tomer-gilan/Technion_Voice_Assistant_Summer_2026_A2/Documentation/edge-cases.md

<div dir="rtl">

# מקרי קצה (Edge Cases) - עוזר קולי על ESP32

קבוצה A2, קורס IoT, קיץ 2026.

מקרים שהמערכת יודעת לטפל בהם, ואיך רואים אותם בהדגמה.

</div>

<table dir="rtl">
<thead>
<tr><th align="center">#</th><th>המקרה</th><th>מה המערכת עושה</th><th>איך מדגימים</th></tr>
</thead>
<tbody>
<tr><td align="center">1</td><td>רעש בחדר במצב Hands-free (דפיקה על השולחן, מחיאת כף, צעדים)</td><td>גלאי הדיבור מזהה שזה לא דיבור, ולא מתחיל להקליט.</td><td>דופקים על השולחן ומוחאים כף ליד המכשיר. המצב נשאר Waiting for speech.</td></tr>
<tr><td align="center">2</td><td>שקט</td><td>במצב Hands-free שקט לא נשלח לענן בכלל. כשמשתמשים בכפתור, המערכת עונה במשפט כללי.</td><td>מפעילים Hands-free ושותקים: לא מתחילה הקלטה. לוחצים Talk ושותקים: העוזר עונה במשפט כללי.</td></tr>
<tr><td align="center">3</td><td>לחיצה על Talk כשהעוזר עדיין עונה</td><td>אי אפשר להתחיל הקלטה שנייה בזמן שהעוזר מדבר (גם בזמן ברכה, הודעת טיימר או תשובה לשאלה מוקלדת): הבקשה נדחית (גם <code>LISTEN</code> מהטרמינל וגם כפתור ה-BOOT, עם הודעה). מחכים שיסיים, או לוחצים Cancel.</td><td>באמצע תשובה כפתור ה-Talk מציג Busy ואי אפשר ללחוץ עליו, וגם מקש הרווח לא מתחיל הקלטה.</td></tr>
<tr><td align="center">4</td><td>הפסקה קצרה באמצע משפט</td><td>ההקלטה ממשיכה עד שנייה של שקט בערך (אפשר לשנות ב-Stop after silence).</td><td>אומרים משפט עם עצירה קצרה באמצע. הוא נשלח כשאלה אחת.</td></tr>
<tr><td align="center">5</td><td>החיבור ל-OpenAI נופל</td><td>הלוח מתחבר מחדש לבד, עם המתנה שגדלה בין ניסיון לניסיון (backoff: בערך 1, 2, 4 ו-8 שניות). אחרי 5 ניתוקים ברצף, או אחרי 30 שניות בלי חיבור, הוא עובר ל-Offline (נורית OpenAI אדומה) וממשיך לנסות כל 30 שניות, בלי להפסיק. כשהחיבור חוזר הוא מתאושש לבד.</td><td>מכבים בטלפון את הנתונים הסלולריים. אחרי כחצי דקה נורית ה-OpenAI נהיית כתומה, ואחרי עוד 30 שניות אדומה. מדליקים אותם שוב, ותוך 30 שניות לכל היותר הנורית חוזרת לירוק לבד.</td></tr>
<tr><td align="center">6</td><td>החיבור ל-Wi-Fi נופל</td><td>הלוח מזהה את הניתוק תוך כמה שניות ועובר ל-Offline (נוריות ה-Wi-Fi וה-OpenAI אדומות). הוא מנסה להתחבר שוב בעצמו כל 5 עד 15 שניות, בלי הגבלה. אם נשמרה רשת ממרכז הבקרה, אחרי 2 דקות בלי חיבור הוא עובר לרשת מ-<code>SECRETS.h</code>, ובחזרה באותו אופן. כשה-Wi-Fi חוזר הוא מתחבר מיד גם ל-OpenAI.</td><td>מכבים את ה-hotspot לכמה שניות ומדליקים אותו שוב. תוך כמה שניות נוריות ה-Wi-Fi וה-OpenAI נהיות אדומות (ב-OpenAI כתוב <code>waiting for Wi-Fi</code>), ואחרי שה-hotspot חוזר הן חוזרות לירוק לבד תוך כ- 5 עד 15 שניות.</td></tr>
<tr><td align="center">7</td><td>איפוס הלוח (Reset)</td><td>ההגדרות (עוצמת שמע, השתקה, בהירות, ספי האור, Hands-free) נשמרות ב-flash וחוזרות אחרי ההדלקה.</td><td>משנים את עוצמת השמע, לוחצים Reset, ובודקים שהעוצמה נשארה.</td></tr>
<tr><td align="center">8</td><td>מרכז הבקרה מתנתק באמצע</td><td>מופיע באנר אדום, וכשמתחברים שוב הדף מתחבר מחדש לבד ומקבל את המצב הנוכחי (STATUS).</td><td>לוחצים Disconnect ואז Connect, או מנתקים את כבל ה-USB ומחברים אותו שוב. כל הנוריות והמצב מופיעים שוב.</td></tr>
<tr><td align="center">9</td><td>עוצמת שמע מחוץ לטווח</td><td>הלוח מגביל את עוצמת השמע לטווח 0 עד 100.</td><td>אומרים <code>Set the volume to 150 percent</code>. העוצמה נעצרת ב-100%.</td></tr>
<tr><td align="center">10</td><td>דיבור ממרחק רגיל (מטר) עם רעש רקע</td><td>גלאי הדיבור מזהה את הדיבור גם כשיש רעש ברקע, והעוזר מבין את הבקשה ומבצע אותה.</td><td>אדם אחד מתופף על השולחן, והשני עומד במרחק מטר מהמכשיר ואומר <code>Turn on the light</code>. ה-LED נדלק.</td></tr>
<tr><td align="center">11</td><td>הטיימר נגמר כשאין חיבור ל-OpenAI</td><td>הטיימר רץ על הלוח עצמו, ולכן הוא מצפצף ומהבהב גם בלי אינטרנט. רק ההודעה הקולית צריכה חיבור: אם אין חיבור כשהטיימר נגמר, היא לא נאמרת.</td><td>מפעילים <code>Set a timer for 30 seconds</code> ומכבים את ה-hotspot. אחרי 30 שניות הלוח מצפצף.</td></tr>
<tr><td align="center">12</td><td>כמה בקשות חומרה בפקודה אחת</td><td>העוזר מזהה את כל הבקשות שבפקודה ומבצע את כולן יחד.</td><td>אומרים <code>Set the light brightness and the volume to 100 percent</code>. גם בהירות ה-LED וגם עוצמת השמע עולות ל-100%.</td></tr>
</tbody>
</table>
