tomer-gilan/Technion_Voice_Assistant_Summer_2026_A2/Documentation/user-stories.md

<div dir="rtl">

# USER STORIES - VOICE ASSISTANT

כל סיפור אומר **מה** המשתמש רוצה, והעמודה "הפתרון שלנו" אומרת **איך** בחרנו לממש את זה.

## הפעלה ושיחה בקול

<table dir="rtl">
<thead>
<tr><th align="center">#</th><th>סיפור המשתמש</th><th>הפתרון שלנו</th><th>מה עושים</th><th>מה אמור לקרות</th></tr>
</thead>
<tbody>
<tr><td align="center">1</td><td>בתור משתמש, אני רוצה <strong>לקבל תמונת מצב של תקינות הרכיבים במכשיר</strong>, כדי לדעת שהוא מוכן לשימוש.</td><td>לוח תקינות במרכז הבקרה עם נורית חיווי לכל רכיב, ותשובה קולית על מצב המכשיר בעקבות פקודה קולית מתאימה.</td><td>מחברים לחשמל ולוחצים Connect board. אחר כך אומרים <code>How are you doing</code>.</td><td>הנוריות נהיות ירוקות (Wi-Fi, SD card, Microphone, Speaker, OpenAI) והעוזר אומר ברכת פתיחה. עד שהשעון מסונכרן, נורית OpenAI מראה <code>Syncing the clock…</code>. לשאלה העוזר עונה כמה חזק אות ה-Wi-Fi, כמה זמן הלוח דלוק וכמה זיכרון פנוי.</td></tr>
<tr><td align="center">2</td><td>בתור משתמש, אני רוצה <strong>אפשרות להתחיל הקלטה בצורה נוחה ופשוטה מתוך הממשק</strong>, ולקבל תשובה בקול.</td><td>כפתור Talk במרכז הבקרה (או מקש רווח), ותשובה קולית מהרמקול שעל הלוח.</td><td>לוחצים Talk ושואלים <code>What is the capital of France</code>. רעיונות לשאלות בכרטיס Try saying.</td><td>הרמקול עונה תוך כשנייה.</td></tr>
<tr><td align="center">3</td><td>בתור משתמש, אני רוצה <strong>לעקוב בנוחות אחרי היסטוריית השיחה הנוכחית</strong>, כדי שיהיה לי תיעוד של השאלה ושל התשובה.</td><td>צ'אט במרכז הבקרה שמציג את השאלות והתשובות כבועות, עם מחוון מצב ותגית לכל פעולה שהמכשיר ביצע.</td><td>מסתכלים במרכז הבקרה בזמן השאלה.</td><td>המצב משתנה (Listening, Processing, Speaking), והשיחה מופיעה כבועות עם שעה וזמן תגובה. כשהעוזר מפעיל משהו בלוח (LED, חלק היום, עוצמה, טיימר, שעה, מצב הלוח) מופיעה בבועה תגית שאומרת מה הופעל.</td></tr>
</tbody>
</table>

## שליטה במכשיר בקול

<table dir="rtl">
<thead>
<tr><th align="center">#</th><th>סיפור המשתמש</th><th>הפתרון שלנו</th><th>מה עושים</th><th>מה אמור לקרות</th></tr>
</thead>
<tbody>
<tr><td align="center">4</td><td>בתור משתמש, אני רוצה <strong>לשלוט בתאורה בדיבור בלבד</strong>, בלי לגעת בכלום.</td><td>פקודה קולית שמדליקה, מכבה ומעמעמת את ה-LED שעל הלוח, עם אישור בקול.</td><td>אומרים <code>Turn on the light</code>, אחר כך <code>Dim the light to 30 percent</code>, ובסוף <code>Turn off the light</code>.</td><td>ה-LED נדלק והעוזר מאשר בקול. בעמעום סליידר הבהירות זז, ובסוף ה-LED נכבה.</td></tr>
<tr><td align="center">5</td><td>בתור משתמש, אני רוצה <strong>לשנות את עוצמת הקול של המכשיר בלי לגשת למחשב</strong>.</td><td>פקודה קולית לעוצמה, באחוזים או ביחס לעוצמה הנוכחית, עם אישור בקול. סליידר העוצמה במרכז הבקרה מתעדכן לבד.</td><td>אומרים <code>Set the volume to 30 percent</code>, אחר כך <code>A bit louder</code>.</td><td>סליידר העוצמה זז ל-30% והעוזר מאשר. בבקשה השנייה העוצמה עולה.</td></tr>
<tr><td align="center">6</td><td>בתור משתמש, אני רוצה <strong>תזכורות וטיימרים, ולדעת מה השעה</strong>, כדי לא לשכוח משהו בזמן שאני עסוק.</td><td>טיימר ותזכורת בפקודה קולית, עם ספירה לאחור במרכז הבקרה. בסוף: צפצוף, LED מהבהב והודעה קולית. אפשר לתזמן גם פעולה (כיבוי האור). את השעה העוזר אומר לפי שעון שמסונכרן מהרשת.</td><td>אומרים <code>Remind me in 30 seconds to check the oven</code>. אחר כך <code>Turn off the light in 20 seconds</code>, ובסוף <code>What time is it</code>.</td><td>במסך רואים ספירה לאחור. בסוף התזכורת הלוח מצפצף 3 פעמים, ה-LED מהבהב והעוזר אומר <code>Time's up - check the oven</code>. האור נכבה בסוף הטיימר השני. העוזר אומר את השעה.</td></tr>
<tr><td align="center">7</td><td>בתור משתמש, אני רוצה <strong>שהמכשיר ידע אם עכשיו יום, ערב או לילה לפי האור בחדר</strong>.</td><td>חיישן אור שהערך שלו מתורגם לחלק היום לפי ספים, ותשובה בקול. החיישן מדומה בסליידר במרכז הבקרה (לפי הנחיית מרצה הקורס).</td><td>מזיזים את סליידר Light sensor לערך נמוך ושואלים <code>Is it day or night</code>. מעלים את הערך ושואלים שוב. אפשר גם Simulate: Auto day-cycle (יום מדומה בכ-2 דקות, עם רעש כמו של חיישן אמיתי). נגיעה בסליידר מחזירה ל-Manual.</td><td>בערך נמוך העוזר עונה <code>night</code>, ובערך גבוה <code>day</code>. ב-Auto day-cycle הערך עובר לבד לילה, זריחה, יום ושקיעה.</td></tr>
</tbody>
</table>

## תקשורת נוחה וגמישה

<table dir="rtl">
<thead>
<tr><th align="center">#</th><th>סיפור המשתמש</th><th>הפתרון שלנו</th><th>מה עושים</th><th>מה אמור לקרות</th></tr>
</thead>
<tbody>
<tr><td align="center">8</td><td>בתור משתמש, אני רוצה <strong>יכולת לדבר עם המכשיר בקלות, בלי לחיצות כפתור</strong>, גם כשהידיים שלי תפוסות.</td><td>מצב Hands-free: זיהוי דיבור על הלוח שמתחיל להקליט לבד כשמדברים, עוצר כשמפסיקים ומתעלם מרעשים קצרים. מפעילים אותו במתג במרכז הבקרה או בפקודה קולית.</td><td>מדליקים את מתג Hands-free ואומרים משפט. אפשר גם בקול: עם Talk אומרים <code>Switch to hands-free mode</code>, ובחזרה <code>Go back to the button</code>.</td><td>הלוח מתחיל להקליט לבד, עוצר כשמפסיקים לדבר, ועונה. בבקשה בקול המתג זז לבד, אבל שאלה על המצב (<code>What is hands-free?</code>) לא מזיזה אותו.</td></tr>
<tr><td align="center">9</td><td>בתור משתמש, אני רוצה <strong>לנהל שיחה טבעית, שבה המכשיר זוכר מה אמרתי קודם</strong>.</td><td>שיחה רציפה מול OpenAI ששומרת את ההקשר של השאלות הקודמות.</td><td>אומרים <code>My name is Omri</code>, ואחר כך שואלים <code>What is my name</code>.</td><td>העוזר עונה <code>Omri</code>.</td></tr>
<tr><td align="center">10</td><td>בתור משתמש, אני רוצה <strong>אפשרות לתקשר עם המכשיר גם בחדר רועש במיוחד</strong>.</td><td>שדה לשאלה בכתב במרכז הבקרה. העוזר עונה עליה בקול, כמו על שאלה מדוברת.</td><td>כותבים בשדה Or type a question… (עד 200 בתים) ולוחצים Ask.</td><td>השאלה מופיעה בשיחה כבועה, והעוזר עונה בקול כרגיל.</td></tr>
<tr><td align="center">11</td><td>בתור משתמש, אני רוצה <strong>לבטל שאלה באמצע</strong>, בלי לחכות לתשובה שכבר לא צריך.</td><td>כפתור Cancel במרכז הבקרה שמוחק את ההקלטה ומחזיר את המכשיר למצב מוכן.</td><td>לוחצים Talk ומיד Cancel.</td><td>ההקלטה נמחקת, העוזר לא עונה והלוח חוזר ל-Ready (בטרמינל: <code>LISTEN #N CANCELLED</code>). כל עוד העוזר מדבר (גם בברכה, בהודעת טיימר או בתשובה לשאלה בכתב), Talk נדחה: מחכים שיסיים, או לוחצים Cancel.</td></tr>
</tbody>
</table>

## תיעוד

<table dir="rtl">
<thead>
<tr><th align="center">#</th><th>סיפור המשתמש</th><th>הפתרון שלנו</th><th>מה עושים</th><th>מה אמור לקרות</th></tr>
</thead>
<tbody>
<tr><td align="center">12</td><td>בתור משתמש, אני רוצה <strong>לשמוע שוב פקודה שאמרתי ותשובה שקיבלתי</strong>, כדי לבדוק מה נקלט.</td><td>ההקלטות נשמרות בכרטיס SD שעל הלוח, ומנגנים אותן במחשב מלשונית ההקלטות במרכז הבקרה.</td><td>בלשונית ההקלטות בוחרים פקודה אחרונה ומנגנים אותה.</td><td>ההקלטה מתנגנת מהמחשב, עם waveform. אפשר גם למחוק אותה. גם עם Hands-free דלוק הלוח לא מתייחס לניגון כשאלה: המיקרופון לא מקשיב עד שהניגון נגמר או נעצר.</td></tr>
</tbody>
</table>

## התאמה אישית

<table dir="rtl">
<thead>
<tr><th align="center">#</th><th>סיפור המשתמש</th><th>הפתרון שלנו</th><th>מה עושים</th><th>מה אמור לקרות</th></tr>
</thead>
<tbody>
<tr><td align="center">13</td><td>בתור משתמש, אני רוצה <strong>להתאים את הקול והתאורה של המכשיר לחדר</strong>.</td><td>סליידרים ומתגים במרכז הבקרה: עוצמה (עם Test beep), השתקה ובהירות LED.</td><td>מזיזים את סליידר העוצמה ולוחצים Test beep, מסמנים Mute, משנים את בהירות ה-LED.</td><td>הצפצוף נשמע בעוצמה החדשה, Mute משתיק את הרמקול, וה-LED משנה בהירות.</td></tr>
<tr><td align="center">14</td><td>בתור משתמש, אני רוצה <strong>שהמכשיר יגיב לדיבור שלי אבל לא יופעל סתם מרעש</strong>, ולא יקטע אותי באמצע משפט.</td><td>כיוון של Hands-free במרכז הבקרה: רגישות (Sensitivity) ומשך השקט שמסיים הקלטה (Stop after silence).</td><td>משנים Sensitivity ו-Stop after silence ובודקים שוב דיבור ורעש.</td><td>דיבור עדיין מפעיל הקלטה, ורעש קצר (דפיקה) לא. ההקלטה נעצרת אחרי זמן השקט שנבחר.</td></tr>
</tbody>
</table>

## בלי מחשב

<table dir="rtl">
<thead>
<tr><th align="center">#</th><th>סיפור המשתמש</th><th>הפתרון שלנו</th><th>מה עושים</th><th>מה אמור לקרות</th></tr>
</thead>
<tbody>
<tr><td align="center">15</td><td>בתור משתמש, אני רוצה <strong>יכולת להפעיל את המכשיר גם בלי לפתוח את מרכז הבקרה</strong>.</td><td>הפעלת האזנה בלחיצה על כפתור BOOT שעל הלוח, כחלופה לכפתור Talk.</td><td>פעם אחת מדליקים BOOT button בכרטיס On the board itself (הבחירה נשמרת בלוח). מעכשיו לוחצים על BOOT שעל הלוח ושואלים <code>What time is it</code>, בלי לגעת במרכז הבקרה.</td><td>נשמע צליל קצר וגבוה, הלוח מקליט 3 שניות והעוזר עונה בקול. לחיצה כשהלוח לא יכול להקשיב (למשל באמצע תשובה, או בלי רשת) נותנת צליל נמוך וקצר.</td></tr>
</tbody>
</table>

## סטטיסטיקה

<table dir="rtl">
<thead>
<tr><th align="center">#</th><th>סיפור המשתמש</th><th>הפתרון שלנו</th><th>מה עושים</th><th>מה אמור לקרות</th></tr>
</thead>
<tbody>
<tr><td align="center">16</td><td>בתור משתמש, אני רוצה <strong>לקבל סטטיסטיקות על פעילות המכשיר במהלך הסשן</strong>, כדי לדעת כמה מהר הוא עונה ובמה השתמשתי.</td><td>חלונית Statistics במרכז הבקרה עם מדדים וגרף, ייצוא ל-CSV, ומסך סיכום שנשמר כדוח.</td><td>פותחים את חלונית Statistics, לוחצים Export CSV, ובסוף Summary ו-Save report.</td><td>בחלונית: מספר הפקודות, זמן תגובה ממוצע, הכי מהיר והכי איטי, הפעלות בקול (LED, עוצמה), שינויים בחיישן האור, וגרף של זמן התגובה לכל פקודה. ה-CSV כולל תאריך ושעה, מספר ההפעלה של הלוח ומספר הפקודה בה. Summary מראה הכל בגדול עם ההגדרות של הלוח, ו-Save report שומר דף HTML אחד.</td></tr>
</tbody>
</table>

</div>
