tomer-gilan/Technion_Voice_Assistant_Summer_2026_A2/docs/quick-start.pdf

# מדריך מהיר - עוזר קולי על 32ESP

קבוצה 2A, קורס IoT, קיץ .2026 דף אחד כדי להפעיל את המערכת לבד. כל הקוד והמסמכים נמצאים בריפו ב-GitHub( סורקים את ה-QR).

## להתחיל

.1 הלוח מחובר ב-USB למחשב, וה-hotspot של הטלפון דלוק. .2 ב-Chrome פתוח מרכז הבקרה ) html.app_audio_reply/tools) . לוחצים board Connect ובוחרים את ה-COM של הלוח. .3 מחכים שכל הנורות למעלה יהיו ירוקות. העוזר אומר משפט פתיחה. אפשר ללחוץ test-Self לבדיקה מהירה של כל החלקים. .4 לוחצים Talk( או רווח( ומדברים באנגלית, עד 3 שניות. או מדליקים free-Hands ופשוט מדברים. לא מכירים את המסך? כפתור Tour למעלה עושה סיור קצר.

## מה לנסות

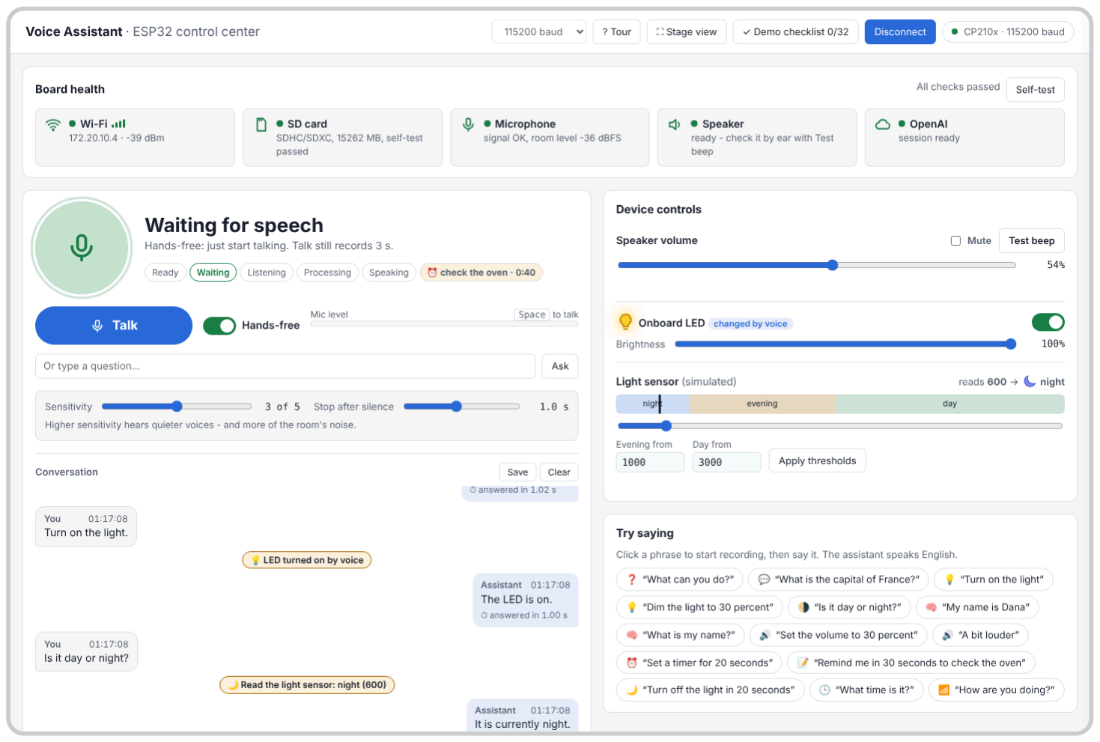
[picture p7: figure]

| | נושא מה להגיד מה יקרה
| | מה הוא יודע ?do you can What הוא מפרט במשפט אחד
| | שאלה כללית ?France of capital the is What עונה בקול תוך כשנייה
ה-LED נדלק ומתעמעם, והנורה במסך זוהרת בהתאם | ואז Turn on the light Dim the light to 30 percent | אור
הסליידר זז והוא מאשר | ואז Set the volume to 30 percent A bit louder | עוצמה
LED , צפצופים ובסוף , לאחור ספירה מהבהב Time's up - check the oven -ו | Remind me in 30 seconds to check the oven | תזכורת
| | שעה ?it is time What השעה והתאריך מהשעון של הלוח
| | חלק היום ?night or day it Is לפי סליידר האור )מדמה חיישן(
השם את זוכר | What is my name? ואז My name is Dana | זיכרון

## מה רואים במסך

העיגול הגדול: מה העוזר עושה עכשיו. ירוק מוכן, אדום מקשיב, כתום חושב, כחול מדבר. Conversation: מה הוא שמע ומה ענה, תוך כמה זמן, ומה הוא הפעיל בלוח. controls Device: עוצמה, השתקה, LED וחיישן האור. ההגדרות נשמרות בלוח גם אחרי Reset. Statistics: כמה פקודות, זמני תגובה וגרף. Summary מציג הכל במסך מלא. view Stage( מקש F): העוזר בגדול, למי שעומד רחוק.

## אם משהו לא עובד

| מה רואים מה עושים
| נורית אדומה ב-Fi-Wi או ב-OpenAI לבדוק את ה-hotspot וללחוץ (EN (Reset על הלוח
| באנר אדום על ה-USB לחבר את הכבל שוב. מרכז הבקרה מתחבר לבד
אפשר לכתוב את השאלה בשדה שמתחת ל-Talk | הוא לא הבין לדבר קרוב יותר, באנגלית, ולבדוק בבועה מה הוא שמע. בחדר רועש
| free-Hands נדלק מרעש להוריד את Sensitivity, או להשתמש ב-Talk
