tomer-gilan/Technion_Voice_Assistant_Summer_2026_A2/docs/questions.md

<div dir="rtl">

# שאלות שבוחנים עשויים לשאול - ותשובות קצרות

קבוצה A2, קורס IoT, קיץ 2026. דף הכנה לצוות לפני ההדגמה. כל המספרים מה-[README](../README.md) ומ-[איך הקוד בנוי](architecture.md).

## חומרה וזיכרון

**למה לא מקליטים את כל השאלה ואז שולחים?**

ל-ESP32 שלנו אין PSRAM. 3 שניות של אודיו ב-24kHz ו-16 ביט הן כ-144KB, וכשהחיבור ל-OpenAI פתוח נשארים פנויים רק כ-45KB. לכן כל חתיכה של 100ms נשלחת מיד.

**למה התשובה מגיעה ב-mu-law ב-8kHz?**

זה קטן פי 6 מ-PCM ב-24kHz (64 kbps במקום 384), אז התשובה נכנסת במאגר הניגון של 32KB. האיכות מספיקה לדיבור.

**מה תופס הכי הרבה זיכרון?**

החיבור המוצפן וה-WebSocket, כ-51KB. בזמן שיחה נשארים כ-45KB פנויים, יציב לאורך 26 שאלות, כלומר אין דליפה.

**איך המיקרופון והרמקול עובדים ביחד?**

שניהם על אותם שעוני I2S (BCLK ו-LRC מחוברים לשניהם), עם פורט I2S אחד במצב full-duplex. ראו את [דיאגרמת החיבורים](images/wiring.png).

## תוכנה

**מה קורה כשהרשת איטית?**

משימת FreeRTOS נפרדת קוראת את המיקרופון כל 20ms לתור של כ-1.36 שניות. שליחה איטית רק מעכבת את האודיו ולא מאבדת אותו. את זה מצאנו במדידות: לפני התיקון אבדו דגימות ב-21 מתוך 26 שאלות.

**איך המודל מדליק את ה-LED?**

בהודעת ההגדרות לסשן הגדרנו 6 "כלים" עם סכמת JSON. המודל מחליט לקרוא לכלי, ה-ESP32 מבצע ומחזיר תשובה, והמודל אומר בקול מה נעשה. הקוד לא מנסה להבין טקסט בעצמו.

**איך Hands-free יודע שזה דיבור ולא דפיקה?**

גלאי הקול בודק עוצמה בתחום התדרים של דיבור לעומת רעש החדר, אם הקול "קולי", ואם יש בו קצב של הברות. דפיקות, מחיאות כפיים וצעדים אף פעם לא התחילו הקלטה בבדיקה על 112 קטעי רעש.

**למה העוזר לא עונה לעצמו?**

בזמן תשובה ועוד 0.6 שניות אחריה המיקרופון לא מקשיב (half-duplex).

**מה נשמר אחרי Reset?**

עוצמה, השתקה, בהירות LED, ספי האור והגדרות Hands-free, ב-flash (NVS, דרך `Preferences`).

**איך מעבירים קבצים מה-SD למחשב בלי Wi-Fi נוסף?**

באותו כבל USB. הלוח שולח את הבייטים בין `@@GET_BEGIN` ל-`@@GET_END`, ומרכז הבקרה בודק CRC-32 כדי לדעת שהקובץ הגיע שלם.

## ביצועים

**כמה מהר הוא עונה?**

חציון של כ-1.1 שניות מסוף ההקלטה עד הצליל הראשון. 23 מתוך 26 שאלות התחילו לענות תוך פחות מ-2 שניות. האיטיות היו בדיבור שקט או מרחוק.

**כמה זמן לוקחת הדלקה?**

6.8 עד 10.8 שניות עד שמוכן לשיחה. החלק הארוך הוא החיבור המוצפן ל-OpenAI, 3.9 עד 5.1 שניות.

## מגבלות

**למה רק אנגלית?**

ניסינו עברית: התשובות חזרו באנגלית והתמלול השתבש.

**מה קורה בלי אינטרנט?**

העוזר לא עונה. טיימר שכבר רץ עדיין מצלצל, כי הוא רץ על הלוח עצמו.

**מה הייתם משפרים?**

הצעה (כדאי להחליט ביחד): חיבור LDR אמיתי (הקוד כבר מוכן), עברית, ותגובה מהירה יותר בדיבור שקט.

</div>
