tomer-gilan/Technion_Voice_Assistant_Summer_2026_A2/docs/versions.md

<div dir="rtl">

# גרסאות הפרויקט - איך בנינו את העוזר, שלב אחר שלב

קבוצה A2, קורס IoT, קיץ 2026. בנינו את הפרויקט בצעדים קטנים. כל שלב הוא sketch שלם שעובד לבד, ובראש כל קובץ כתוב מה הוא מוסיף ואיך בודקים שהוא עבר. השלבים הישנים נשמרו בתיקייה `test/` בשם `NN_*.ino.inactive`, כדי שה-Arduino IDE לא יקמפל אותם. הגרסה הנוכחית היא `test/test.ino` (שלב 30 והשיפורים שאחריו).

## 1. החומרה (שלבים 2-5)

| שלב | מה נבדק |
|---|---|
| 02 | צליל 440Hz ברמקול דרך המגבר MAX98357A. בודק את החיבורים של הרמקול |
| 03 | המיקרופון INMP441: מדפיס מינימום, מקסימום ו-RMS כל חצי שנייה |
| 04 | הקלטה ואז השמעה (loopback). שני הרכיבים חולקים את אותם שעוני I2S |
| 05 | חיבור ל-Wi-Fi, עם חיבור מחדש אוטומטי |

## 2. ניסיון ראשון עם Gemini Live (שלבים 6-8)

| שלב | מה נבדק |
|---|---|
| 06 | חיבור מוצפן (TLS + WebSocket) לשרת של Gemini |
| 07a / 07b | הודעת הגדרה מינימלית, ואחר כך מלאה עם הוראות וכלי ל-LED |
| 08a | שאלה בטקסט ותשובה. למדנו שמודלי האודיו של Gemini עונים רק באודיו, לא בטקסט |
| 08b | שליחת אודיו אמיתי מהמיקרופון בחתיכות של 100ms, בלי לשמור את כל ההקלטה ב-RAM |

## 3. מעבר ל-OpenAI Realtime (שלבים 9-16)

| שלב | מה נוסף |
|---|---|
| 09 | חיבור מוצפן ל-OpenAI עם אימות בכותרת `Authorization` |
| 10 | הודעת `session.update` (מודל, הוראות, פורמט אודיו) ואישור מהשרת |
| 11 | שאלה בטקסט ותשובה |
| 12 | אודיו מהמיקרופון לשרת, בחתיכות קטנות |
| 13 | השמעת התשובה ברמקול, חתיכה אחרי חתיכה |
| 14 | תמלול של שני הצדדים, ושיחה שזוכרת את השאלות הקודמות |
| 15 | הכלי הראשון: `set_board_state` מדליק ומכבה את ה-LED |
| 16 | הרבה שאלות ברצף וחיבור מחדש ברור כשהרשת נופלת |

## 4. סדר בקוד והתנהגות (שלבים 17-22)

| שלב | מה נוסף |
|---|---|
| 17 | פקודות לוג (`LOG_ERROR` / `LOG_INFO` / `LOG_DEBUG`) במקום הדפסות מפוזרות |
| 18 | תשובות קצרות: משפט אחד |
| 19 | לחיצה על כפתור BOOT מתחילה הקלטה, כמו הפקודה `LISTEN` |
| 20a | פירוק הקוד למודולים (`*_utils.cpp/.h`) |
| 21 | תיקון באג: שקט חוזר הדליק וכיבה את ה-LED בלי שביקשו |
| 22 | ברכת פתיחה אקראית כשהלוח מוכן |

## 5. יכולות (שלבים 23-29)

| שלב | מה נוסף |
|---|---|
| 23 | הכלי `get_time_of_day`: יום, ערב או לילה לפי חיישן אור (בהתחלה מדומה) |
| 24 | כרטיס SD לצד החיבור ל-OpenAI, ומדידת זיכרון בכל שלב בהדלקה |
| 25 | שמירת התשובות ב-SD, והעברת קבצים למחשב (`LIST` / `GET` / `DELETE`) |
| 27 | שמירת ההקלטה מהמיקרופון ב-SD, כדי לשמוע מה הלוח שמע |
| 28 | מרכז הבקרה בדפדפן: שורות `@@` עם מצב הלוח, וכפתורים ל-LED, עוצמה וצפצוף |
| 29 | מדידות זמן וזיכרון בכל שאלה, וסקריפט שמסכם אותן (ראו "מדידות ביצועים" ב-README) |

אין קובץ לשלב 26. הקוד של שלב 28 נמצא בתוך שלב 29, שבנוי ישירות עליו.

## 6. הגרסה הנוכחית (שלב 30, `test/test.ino`)

| מה | איפה |
|---|---|
| Hands-free: גלאי קול (VAD) שמתחיל ועוצר את ההקלטה לבד | `vad_utils`, `hands_free_utils` |
| משימה נפרדת שקוראת את המיקרופון כל 20ms, עם 500ms לפני תחילת הדיבור | `mic_capture_utils` |
| כלי לבדיקת הגלאי על קבצי WAV במחשב | `tools/vad_replay.cpp` |
| מרכז הבקרה: Hands-free, מד עוצמת קול, סליידרים, סטטיסטיקה | `tools/reply_audio_app.html` |

### השיפורים לקראת ההגשה

| תחום | מה נוסף |
|---|---|
| כלים קוליים | עוצמה באחוזים (`set_volume`), עמעום, שעה ותאריך, טיימר ותזכורת, `How are you doing?` (`get_board_status`), `What can you do?` |
| קושחה | הטיימר מצלצל גם בלי אינטרנט, שאלה בכתב לחדר רועש (`ASK`), תמיכה ב-LDR אמיתי |
| מרכז הבקרה | Tour לבוחנים, Self-test, Demo checklist שמסמן לבד, שעון הדגמה, Stage view, Summary, Save report, ניגון לוג שמור |
| מסמכים | README ויזואלי, סיפורי משתמש ומקרי קצה להדפסה, מדריך מהיר, תוכנית הדגמה, מבנה הקוד, דיאגרמת חיבורים, והמסמך הזה |

הרשימה המלאה, commit אחרי commit: [PROGRESS.md](../PROGRESS.md).

## גרסאות התוכנה

גרסאות ה-IDE, ה-ESP32 core, הספריות והמודל: בטבלה "תוכנה וגרסאות" ב-[README](../README.md).

</div>
