tomer-gilan/Technion_Voice_Assistant_Summer_2026_A2/docs/edge-cases.pdf

# מקרי קצה - עוזר קולי על 32ESP

### קבוצה 2A, קורס IoT, קיץ .2026

מקרים שהמערכת יודעת לטפל בהם, ואיך אפשר לראות את זה בהדגמה.

| | | # המקרה מה המערכת עושה איך מדגימים ✓
.speech | גלאי הקול מזהה שזה לא דיבור ולא מתחיל להקליט. דופקים על השולחן ומוחאים כפיים ליד המכשיר. המצב נשאר for Waiting | על השולחן, מחיאת כפיים, צעדים( | 1 רעש בחדר במצב free-Hands( דפיקה
משתעלים ליד המכשיר. ב-GUI מופיעה הודעה שהצליל נזרק, או בבועה כתוב .(no words - just a sound) | נשלחה ו-OpenAI לא שמע מילים, זה נספר כרעש והמודל לא מפעיל את ה-.LED | | 2 צליל שדומה לדיבור )שיעול, צחוק( אם ההקלטה התחילה והתברר שזה לא דיבור, היא נזרקת ולא נשלחת. אם
מוחאים כפיים או משתעלים כמה פעמים ברצף. ב-GUI מופיעה הודעה על הפסקה. | הזמן. | | 3 הרבה רעשים ברצף אחרי 3 רעשים ברצף ההאזנה עוצרת ל5- שניות, כדי לא לשלוח רעש לענן כל
free-Hands דלוק, שואלים שאלה עם תשובה ארוכה. אחרי התשובה הוא חוזר ל-Waiting ולא מתחיל שיחה לבד. | את עצמו. | | 4 העוזר שומע את עצמו מהרמקול בזמן תשובה ו0.6- שניות אחריה המיקרופון לא מקשיב, כך שהעוזר לא מפעיל
free-Hands דלוק ושותקים: לא מתחילה הקלטה. | הוראה להפעיל את ה-LED רק אם שמע בקשה ברורה. | | 5 שקט במצב free-Hands שקט לא נשלח לענן בכלל. במצב לחיצה, המודל מקבל
באמצע תשובה הכפתור Talk כתוב Busy ולא לוחץ, וגם רווח לא מתחיל הקלטה. | נדחה עם הודעה שהמיקרופון תפוס. | | 6 לוחצים Talk כשהעוזר עוד עונה אי אפשר להתחיל הקלטה שנייה באמצע תשובה. גם LISTEN מהטרמינל
| | | 7 משפט ארוך מאוד במצב free-Hands ההקלטה נעצרת אחרי 10 שניות לכל היותר, והעוזר עונה על מה שנשמע. מדברים ברצף יותר מ10- שניות. הכפתור מתמלא עד הסוף וההקלטה נעצרת.
| | | 8 הפסקה קצרה באמצע משפט ההקלטה ממשיכה עד שקט של כשנייה )אפשר לשנות ב-silence after Stop). אומרים משפט עם עצירה קצרה באמצע. הוא נשלח כשאלה אחת.
בשורת המדידה של השאלה רואים כמה זמן האודיו חיכה בתור )ms_max_fifo )ושלא אבד כלום. | התור מתמלא, יש הודעה כמה אודיו אבד. | | 9 Fi-Wi איטי בזמן הקלטה האודיו מחכה בתור עד 1.36 שניות ונשלח באיחור במקום ללכת לאיבוד. אם
מכבים את ה-hotspot לכמה שניות ומדליקים. נורית OpenAI חוזרת לירוק. | ניסיונות כושלים ברצף הוא עוצר עם נורית OpenAI אדומה והסבר, במקום לנסות לנצח. | | 10 החיבור ל-OpenAI נופל הלוח מתחבר מחדש לבד, עם המתנה שגדלה בין ניסיונות )backoff). אחרי 5
קשה להדגים בכוונה. מראים את הקוד או לוג. | נתקע. | | 11 השרת לא עונה אחרי 15 שניות בלי הודעה מהשרת השאלה נסגרת עם הודעה, והלוח לא
מוציאים את כרטיס ה-SD ועושים Reset. נורית SD אדומה. | הנורית של הרכיב נהיית אדומה עם סיבה, והלוח עוצר עם הודעה ברורה במקום להיתקע. | )SD | 12 רכיב לא תקין בהדלקה )למשל אין כרטיס
| | | 13 ערך לא חוקי לחיישן האור ערך מחוץ לטווח )0 עד 6142( נדחה עם הודעה, והערך הקודם נשאר. מקלידים 99999 LIGHT בשורת הפקודה.
משנים עוצמה, לוחצים Reset, ובודקים שהעוצמה נשארה. | וחוזרות אחרי העלייה. | | 14 Reset ללוח ההגדרות )עוצמה, השתקה, בהירות, ספי אור, free-Hands )נשמרות ב-flash
מנתקים את כבל ה-USB ומחברים שוב, או לוחצים Disconnect ואז Connect. כל הנורות והמצב מופיעים שוב. | הדף מתחבר לבד ומקבל את המצב הנוכחי )STATUS). | | 15 מרכז הבקרה מתנתק באמצע הלוח ממשיך לעבוד לבד. אם הכבל נותק מופיע באנר אדום, וכשמחברים שוב
| | | 16 בקשה שהלוח לא יודע לבצע המודל מפעיל רק את הכלים שהגדרנו, ואומר מה אי אפשר במקום להמציא. אומרים blue light the Make. העוזר עונה שה-LED הוא בצבע אחד.
.100% | | | 17 עוצמה מחוץ לטווח הלוח מגביל את העוצמה ל0- עד .100 אומרים percent 150 to volume the Set. העוצמה נעצרת על
| | | 18 קובץ שנפגם בהעברה מה-SD למחשב כל קובץ נבדק עם -32CRC, וקובץ פגום מזוהה ולא מנוגן. מראים בקוד. בהדגמה רגילה כל קובץ עובר תקין.
אחרי .hotspot-ה את ומכבים Set a timer for 30 seconds מפעילים 30 שניות הלוח מצפצף. | ההודעה בקול צריכה חיבור: אם אין חיבור כשהטיימר נגמר, היא לא נאמרת. | | 19 הטיימר נגמר כשאין חיבור ל-OpenAI הטיימר רץ על הלוח עצמו, אז הוא מצפצף ומהבהב גם בלי אינטרנט. רק
LED-ה .Ask ולוחצים Talk-ל שמתחת בשדה Turn on the light כותבים נדלק, ובבועה כתוב typed. | עונה בקול כרגיל וגם מפעיל את הלוח. באמצע תשובה הכפתור Ask לא פעיל עד שהעוזר מסיים. | | 20 החדר רועש מדי בשביל לדבר אפשר לכתוב את השאלה במרכז הבקרה. היא נכנסת לאותה שיחה, והעוזר
