tomer-gilan/Technion_Voice_Assistant_Summer_2026_A2/docs/user-stories.pdf

# סיפורי משתמש )Stories User )- עוזר קולי על 32ESP

קבוצה 2A, קורס IoT, קיץ .2026 מטרת הפרויקט: עוזר קולי על בקר זול )32ESP, KB520 זיכרון(. מדברים איתו, הוא עונה בקול ושולט ברכיבים על הלוח. הבנת הדיבור בענן )OpenAI), וכל השאר על הבקר. מרכז בקרה בדפדפן מראה מה קורה ומאפשר לשנות הגדרות. ההדגמות לפי הסדר, מהבסיסי להגדרות ולסטטיסטיקה. רשימה דומה נמצאת גם במרכז הבקרה )כפתור checklist Demo). מי שמפעיל את המערכת בפעם הראשונה יכול ללחוץ Tour ולקבל סיור קצר במסך.

| | | # בתור... אני רוצה... כדי ש... איך מדגימים ✓
Fi-Wi, שעון, OpenAI )והעוזר אומר ברכת פתיחה. | אדע שהוא מוכן לשיחה מחברים לחשמל ולוחצים board Connect במרכז הבקרה. נורות התקינות נהיות ירוקות )SD, מיקרופון ורמקול, | הרכיבים תקינים | 1 משתמש להדליק את המכשיר ולראות שכל
ללחוץ על דוגמה בכרטיס saying Try. | | | 2 משתמש ללחוץ על כפתור ולשאול שאלה אקבל תשובה בקול לוחצים Talk( או רווח(, שואלים France of capital the is What. הרמקול עונה תוך כשנייה. אפשר גם
מדליקים את מתג free-Hands. אומרים משפט. הלוח מתחיל להקליט לבד, עוצר כשמפסיקים לדבר, ועונה. | תפוסות | | 3 משתמש לדבר בלי ללחוץ על כלום אוכל להשתמש בו כשהידיים
.Turn off the light ובסוף ,(זז הבהירות סליידר )percent | | | 4 משתמש להגיד ”תדליק את האור“ האור יידלק בלי לגעת בכלום אומרים light the on Turn. ה-LED נדלק והעוזר מאשר בקול. אחר כך 30 to light the Dim
.louder | | | 5 משתמש לשנות את עוצמת הרמקול בקול לא אצטרך לגעת במחשב אומרים percent 30 to volume the Set. סליידר העוצמה זז ל30%- והעוזר מאשר. אחר כך bit A
הלוח ובסוף , לאחור ספירה רואים במסך .Remind me in 30 seconds to check the oven אומרים Turn off the .Time's up - check the oven אומר והעוזר , מהבהב LED-ה , פעמים 3 מצפצף seconds 20 in light: האור נכבה בסוף הטיימר. אחר כך שואלים it is time What. | לא אשכח משהו בזמן שאני עסוק | השעה | 6 משתמש לבקש טיימר או תזכורת ולשאול מה
מעלים את הערך ושואלים שוב. | | | 7 משתמש לשאול איזה חלק של היום עכשיו העוזר יענה לפי האור בחדר מזיזים את סליידר האור )מדמה את החיישן( לערך נמוך ושואלים night or day it Is. העוזר עונה night.
| | | 8 משתמש שהעוזר יזכור מה אמרתי קודם השיחה תהיה טבעית אומרים Omri is name My, ואחר כך שואלים name my is What.
תגובה. כשהעוזר מפעיל משהו בלוח מופיעה תגית ) LED, 🌙 חלק היום, עוצמה, ⏰ טיימר, שעה, מצב(. | אבין אם הוא הבין אותי במרכז הבקרה רואים את המצב משתנה )Speaking ,Processing ,Listening), ואת השיחה כבועות עם שעה וזמן | ומה ענה | 9 משתמש לראות במחשב מה העוזר שמע
| אוכל לבדוק מה נקלט בלשונית ההקלטות בוחרים פקודה אחרונה ומנגנים אותה מהמחשב, עם waveform. אפשר גם למחוק. | ותשובה שקיבלתי | 10 משתמש לשמוע שוב פקודה שאמרתי
| המכשיר יתאים לחדר מזיזים את סליידר העוצמה ולוחצים beep Test, מסמנים Mute, משנים את בהירות ה-LED. | בהירות LED | 11 משתמש לשנות עוצמה, להשתיק ולשנות
משנים Sensitivity ו-silence after Stop ובודקים שוב דיבור ורעש. | הוא לא יופעל סתם ולא יקטע אותי | free ואת זמן השקט | 12 משתמש לכוון את הרגישות של ה--Hands
| הם יתאימו לתאורה אצלי משנים את הספים ולוחצים thresholds Apply. הנורית של החלק ביום מתעדכנת. | ולילה | 13 משתמש לשנות את הספים של יום, ערב
| | | 14 משתמש שההגדרות יישמרו לא אצטרך לכוון מחדש כל פעם לוחצים Reset בלוח. אחרי העלייה העוצמה, הבהירות וההגדרות של free-Hands נשארות כמו שהיו.
בחלונית Statistics: מספר הפקודות, זמן תגובה ממוצע, הכי מהיר והכי איטי, הפעלות בקול )LED, עוצמה( ושינויים בחיישן האור. גרף מראה את זמן התגובה של כל פקודה, ו-CSV Export שומר את הנתונים. בסוף לוחצים Summary ורואים את הכל בגדול, עם ההגדרות של הלוח. report Save שומר את הכל כדף HTML אחד. | השתמשתי בו | | 15 משתמש לראות סטטיסטיקה של השימוש אדע כמה מהר הוא עונה וכמה
