tomer-gilan/Technion_Voice_Assistant_Summer_2026_A2/docs/demo-plan.pdf

# תוכנית ההדגמה - 25 דקות

קבוצה 2A, קורס IoT, קיץ .2026 המסמך הזה בשבילנו: מה מכינים, באיזה סדר מדגימים, ומה עושים אם משהו לא עובד. הסדר הולך לפי סיפורי המשתמש ומקרי הקצה, שמודפסים בשני עותקים.

## יום לפני

לצרוב את הקושחה האחרונה ולעבור פעם אחת על כל ה-checklist Demo במרכז הבקרה. לבדוק שהשעה נכונה ) ?it is time What , או השורה clock Board ב-test-Self). כדי שהשעון יעבור לבד לשעון קיץ, להוסיף
.שוב | ולצרוב | #define TIMEZONE_POSIX "IST-2IDT,M3.5.5/2,M10.5.0" את test/config.h -ל
בזמן החזרה, לשמור את הלוג )folder to log Save)…. זה הגיבוי אם אין אינטרנט בהדגמה )ראו למטה(. להדפיס 2 עותקים של סיפורי המשתמש ו2- של מקרי הקצה, ועותק של המדריך המהיר להשאיר ליד הלפטופ. להטעין את הלפטופ ואת הטלפון של ה-hotspot.

## 10 דקות לפני

להדליק hotspot בטלפון, לחבר את הלוח ל-USB, לפתוח את html.app_audio_reply/tools ב-Chrome וללחוץ Connect .board
לחכות שכל הנורות ירוקות ולשמוע את ברכת הפתיחה. ללחוץ test-Self( ליד health Board): ה-LED מהבהב, צפצוף, וכל השורות עם ✓.
.Demo checklist-ב Reset , | בסטטיסטיקה | Reset , | בשיחה | Clear : | לנקות
להתחיל ממצב רגיל: עוצמה כ,60%- LED כבוי, free-Hands כבוי, סליידר האור על day. אם יש מסך גדול או מקרן: view Stage( מקש F )כשמדגימים שיחה. ברגע שמתחילים: checklist Demo“ ← התחלת ההדגמה“. בכותרת מופיע שעון עם השלב שבו צריך להיות לפי הטבלה למטה, והוא נהיה אדום אחרי 25 דקות.

## הסדר

| | | דקות מה מדגימים סיפור / מקרה קצה טיפ
נדלקות אחת אחת | | | 0-2 הדלקה ונורות תקינות סיפור 1 עושים Reset ללוח מול הבוחנים, כדי שיראו את הנורות
בעצמו | סיפורים ,2 9 נותנים לבוחן ללחוץ על דוגמה ב-saying Try ולשאול | במסך | 2-5 שאלה בלחיצה, והשיחה
| סיפור ,3 מקרי קצה 1-3 דפיקה על השולחן ושיעול, ומראים את ההערה בשיחה | מפעיל | 5-8 free-Hands, ורעש שלא
Remind me in 60 seconds to check the oven וממשיכים בינתיים לסעיף הבא. הוא יצלצל ויגיד את התזכורת באמצע | 4-6 סיפורים | עוצמה, תזכורת | 8-12 שליטה בלוח בקול: LED,
| | | 12-14 חלק היום וזיכרון שיחה סיפורים ,7 8 מזיזים את סליידר האור לפני השאלה
| | | 14-16 הקלטות מה-SD סיפור 10 מנגנים את הפקודה האחרונה, רואים waveform
, Make the light blue Set the volume to 150 percent | מקרי קצה ,6 ,15-17 20 Talk באמצע תשובה, ניתוק כבל USB, | המודפסת | 16-20 מקרי קצה מהרשימה
| | | 20-23 הגדרות, ושהן נשמרות סיפורים 11-14 משנים עוצמה ובהירות, Reset ללוח, ומראים שנשארו
שומר את ההדגמה לקובץ, אפשר לשלוח לבוחנים | | | 23-25 סטטיסטיקה וסיכום סיפור 15 מראים את הגרף, ואז Summary למסך מלא. report Save

## לתת לבוחנים להפעיל

עדיף שהבוחנים ינסו בעצמם. אם הם לא מכירים את המסך, ללחוץ Tour: סיור קצר של 9 תחנות שמסביר כל חלק. הכרטיס saying Try נותן להם משפטים מוכנים, וגם המדריך המהיר המודפס. כדאי להזכיר שמדברים באנגלית, קרוב למיקרופון, ושאפשר לשאול כל שאלה, לא רק את הדוגמאות.

## אם משהו לא עובד

| מה קרה מה עושים
לא עובד עם הלוח | נורית Fi-Wi אדומה לבדוק שה-hotspot דלוק ולעשות Reset ללוח. ה-Fi-Wi של הטכניון
מהחזרה. מרכז הבקרה מנגן את השיחה כאילו היא קורית עכשיו. להגיד לבוחנים שזה לוג, לא חי | אין אינטרנט בכלל Disconnect, ואז log a Replay …בטרמינל ולבחור את הלוג
לשאול שוב )מקרה קצה 11( | אין תשובה לשאלה אחרי 15 שניות הלוח מוותר בעצמו, כותב למה, וחוזר ל-Ready.
להסביר | העוזר לא הבין לדבר קרוב יותר ובאנגלית. בבועה רואים מה הוא שמע, וזה עוזר
בקול כרגיל )מקרה קצה 20( | החדר רועש מדי לכתוב את השאלה בשדה שמתחת ל-Talk וללחוץ Ask. הוא עונה
| free-Hands מופעל מרעש בחדר להוריד את Sensitivity, או לכבות free-Hands ולהמשיך עם Talk
| באנר אדום: הכבל התנתק לחבר שוב. מרכז הבקרה מתחבר לבד, והלוח המשיך לעבוד בינתיים
| באנר אדום: הלוח נעצר ללחוץ על כפתור ה-(EN (Reset שעל הלוח
להסביר ולהמשיך | השעה לא נכונה בשעה אחת שעון קיץ: POSIX_TIMEZONE ב- h.config( ראו ”יום לפני“(.
מיד אחריה | הטיימר לא צלצל הוא מחכה שהלוח יהיה פנוי. אם העוזר באמצע תשובה, הצלצול יגיע
