tomer-gilan/Technion_Voice_Assistant_Summer_2026_A2/docs/images/statistics.png

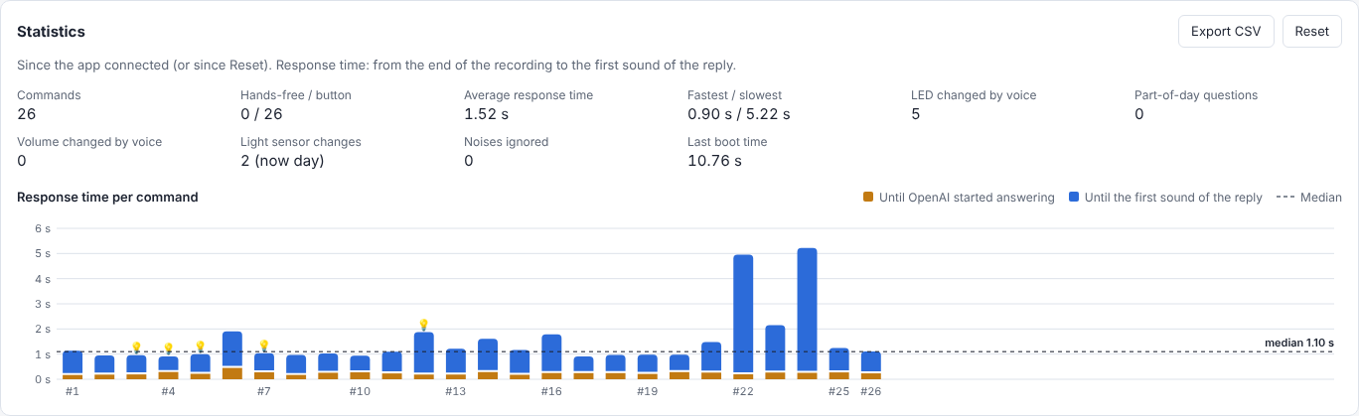
docs/images/statistics.png
