tomer-gilan/Technion_Voice_Assistant_Summer_2026_A2/Documentation/images/stage-view.png

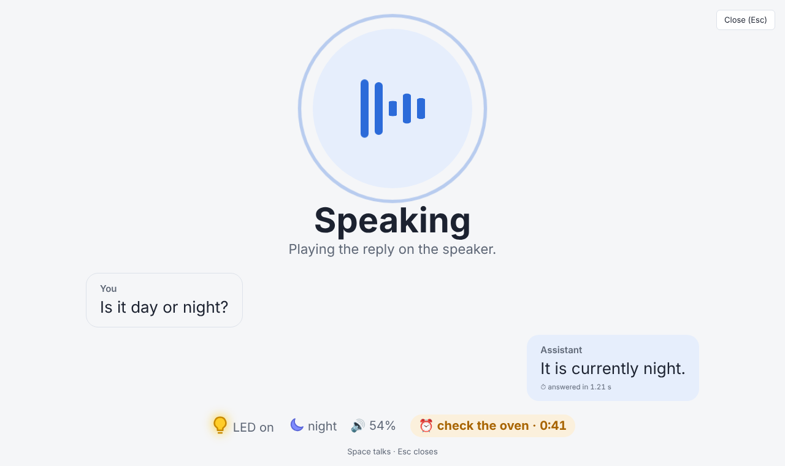
Documentation/images/stage-view.png
