tomer-gilan/Technion_Voice_Assistant_Summer_2026_A2/Documentation/development_steps/decisions.md

<div dir="rtl">

# החלטות משמעותיות ותגליות בדרך

כאן מתועדות ההחלטות המשמעותיות בפרויקט: מה החלטנו, למה, אילו חלופות שקלנו, ועל מה ההחלטה נשענת (מדידה, ניסוי או תיעוד רשמי). 

### מ-Gemini Live ל-OpenAI Realtime

**ההחלטה:** התחלנו עם Gemini Live (החיבור, ההגדרה ושליחת אודיו עבדו) ועברנו ל-OpenAI Realtime.

**למה:** גילינו שמודלי האודיו של Gemini שהיו זמינים עונים רק באודיו ולא מחזירים טקסט של התשובה, בזמן ש-OpenAI מחזיר גם אודיו וגם תמלול של שני הצדדים. התמלול משמש אותנו למרכז הבקרה ולבדיקת התוצאות. ל-OpenAI יש גם מנגנון כלים (function calling) מתועד היטב באותו חיבור. 

### חיבור WebSocket מוצפן אחד, ושליחה בחתיכות של 100ms

**ההחלטה:** כל אודיו המיקרופון נשלח מיד, בחתיכות של 100ms (‏2400 דגימות), על אותו חיבור. אף פעם לא שומרים הקלטה שלמה בזיכרון.

**למה:** 3 שניות של PCM ב-24kHz הן כ-144KB, וכשהחיבור המוצפן פתוח נשארים כ-45KB. שליחה בחתיכות היא הדרך היחידה שזה נכנס. 24kHz הוא קצב הקלט הנמוך ביותר ש-OpenAI מקבל ל-PCM (שלב 10).

### תשובה ב-mu-law ‏8kHz

**ההחלטה:** ביקשנו מ-OpenAI את התשובה ב-G.711 mu-law ב-8kHz, ולא PCM ב-24kHz.

**למה:** בית אחד לדגימה ו-8000 דגימות בשנייה, פי 6 פחות מ-PCM ב-24kHz (‏64 במקום 384 kbps). כך מאגר של 32KB מחזיק כ-4 שניות של תשובה. האיכות מספיקה לדיבור. הפענוח ל-PCM וההעלאה ל-24kHz קורים רק ברגע הניגון.

## זיכרון

### מאגר הניגון מוקצה ב-heap ולא סטטית

**ההחלטה:** המאגר של התשובה (ring buffer) מוקצה פעם אחת ב-`setup()`, לפני ה-Wi-Fi וה-TLS, ולא כמערך סטטי.

**למה:** כשהגדלנו אותו ל-64KB כמערך סטטי, הקישור (linker) נכשל: הקצאה מוקדמת מבטיחה בלוק רציף, לפני שה-TLS מפצל את הזיכרון.

### מאגר של 32KB ולא 64KB

**ההחלטה:** הקטנו את מאגר הניגון מ-64KB ל-32KB כשהוספנו את כרטיס ה-SD.

**למה:** עם ה-SD ו-64KB נשארו רק כ-9KB פנויים כשהסשן מוכן, והשאלה הראשונה גמרה את ה-heap. ניסינו גם 48KB. בחרנו 32KB כדי להשאיר מקום לפיצ'רים הבאים, והתברר שזה הספיק, כי מה שמכתיב את קצב התשובה הוא הלחץ החוזר (הסעיף הבא) ולא גודל המאגר.

### מרכז בקרה דרך USB (Web Serial) ולא שרת על הבקר

**ההחלטה:** מרכז הבקרה הוא דף HTML אחד שמדבר עם הלוח דרך כבל USB (Web Serial), ולא שרת HTTP על ה-ESP32 או אפליקציה.

**למה:** שרת web על הבקר דורש עוד זיכרון בזמן שהחיבור המוצפן פתוח, ושם נשארים כ-45KB. Web Serial לא דורש שום דבר מהלוח חוץ מהדפסת שורות `@@`. הלוח עצמו עובד גם בלי המחשב: Hands-free נשמר ב-flash, ויש כפתור BOOT ו-צלילי מצב כאופציה.

### מצב של Hands-free ולא רק לדיבור אחרי לחיצה על כפתור, ומה קורה בחדר רועש

**ההחלטה:** Hands-free (גלאי הקול על הבקר) הוא אופציה וכבוי כברירת מחדל. Talk, כפתור BOOT (כשמדליקים אותו) ושאלה בכתב (Ask) נשארים תמיד, כך שאף פעם לא חייבים לדבר "חופשי".

**ההנחה:** ש-Hands-free עובד הכי טוב בחדר שקט יחסית. בחדר רועש הגלאי עלול לשמוע רעש כדיבור, ולפספס דיבור שקט.

**מה בדקנו:** ביצענו ניסוי בתנאים שונים (מרחקים שונים מהמיקרופון וסביבה שקטה/רועשת) לבדיקת ייעילות ה- VAD וראינו כי אכן הבקר מצליח להתמודד בהצלחה עם הקלטות hands-free - גם ממרחקים דינאמיי יחסית וגם בסביבה עם רעשים סבירים אך לא זניחים. ניתן לראות תיעוד לניסוי כאן - [ניסוי יעילות VAD](../measurements/latency-vad-analysis.md).

### מעבר בין Hands-free ללחיצה גם בקול, ורק בבקשה מפורשת

**ההחלטה:** החלטנו לאפשר מעבר על ידי פקודה קולית בין מצב hands-free למצב של האזנה בלחיצת כפתור וזאת על מנת לצמצם את התלות בממשק ה-GUI.

### המיקרופון לא מקשיב בזמן שמרכז הבקרה מנגן הקלטה

**הבעיה:** הנגן של ההקלטות מנגן ברמקולים של המחשב. עם Hands-free דלוק, המיקרופון של הלוח שמע את ההקלטה (תשובה או פקודה קולית מה-SD) והתייחס אליה כאל שאלה.

**ההחלטה:** כשהמשתמש נמצא באינטרקציה עם הנגן - למשל מנגן הלקטה של תשובה או פקודה קולית - המיקרופון מפסיק להקליט וכל הקלטה שעשויה הייתה להתרחש בזמן זה מתבטלת.

### משימה נפרדת למיקרופון

**מה מדדנו:** ב-21 מתוך 26 שאלות אבדו דגימות מהמיקרופון. מאגר ה-DMA מחזיק 150ms, ושליחה אחת ב-Wi-Fi לקחה עד 465ms. כמות הקול שאבדה התאימה לשליחה האיטית ביותר באותה שאלה (מקדם מתאם 0.93).

**ההחלטה:** משימת FreeRTOS בעדיפות גבוהה יותר קוראת את המיקרופון כל 20ms לתוך מאגר הניגון, שמושאל לה כל עוד אין מה לנגן. שליחה איטית רק מעכבת את האודיו.

</div>
