tomer-gilan/Technion_Voice_Assistant_Summer_2026_A2/Documentation/calibration.md

<div dir="rtl">

# הוראות כיול

קבוצה A2, קורס IoT, קיץ 2026. שלושה דברים במערכת דורשים כיול: חיישן האור, הרגישות של Hands-free, ועוצמת המיקרופון. שני הראשונים נעשים ממרכז הבקרה ונשמרים בלוח.

## 1. חיישן האור (LDR)

**במערכת ההגשה ה-LDR לא מחובר.** לפי הנחיית מדריך הקורס, ערך החיישן מדומה ממרכז הבקרה (סליידר Light sensor), והספים שלמטה מכוילים מול הערך המדומה. החלק הראשון של הסעיף (חיבור ובדיקה) הוא למקרה שהחיישן יחובר.

**חיבור (רק אם מחברים LDR אמיתי):** LDR ונגד 10kΩ בטור בין 3.3V ל-GND. נקודת האמצע מתחברת ל-GPIO 34 (או לכל פין ADC1 בטווח 32-39, כי ADC2 לא עובד כשה-Wi-Fi דלוק).

**בדיקה לפני הכיול:** צורבים את `Unit Tests/09_light_sensor`. מכסים את החיישן ואז מאירים עליו עם פנס של טלפון.
- מספר גבוה יותר כשיש יותר אור: החיבור נכון.
- המספר עולה כשמכסים: מחליפים בין ה-LDR לנגד.
- הטווח בין חושך לפנס צריך להיות לפחות 1500 (מתוך 4095). אם הוא קטן יותר, מנסים נגד אחר (4.7kΩ או 22kΩ).

**הפעלה בקושחה (רק עם LDR אמיתי):** ב-`ESP32/parameters.h` מורידים את ההערה מהשורה `#define LIGHT_SENSOR_PIN 34`, וצורבים. מעכשיו הלוח קורא את החיישן כל שנייה, והסליידר במרכז הבקרה רק מציג את הערך.

**כיול הספים (בלי קימפול):**
1. בתאורה של "יום" בחדר רושמים את הערך ב-Device controls ← Light sensor (`reads`). בלי LDR מחובר מזיזים את הסליידר לערך שמייצג יום.
2. מחשיכים חלקית (תאורת ערב) ורושמים שוב, ואחר כך בחושך. בלי LDR מזיזים את הסליידר בהתאם.
3. קובעים `Evening from` בין הלילה לערב, ו-`Day from` בין הערב ליום, ולוחצים **Apply thresholds**.
4. שואלים `Is it day or night?` בכל אחד מהמצבים ובודקים את התשובה.

הספים נשמרים ב-flash. הסולם בקושחה הוא 0-6142, כלומר קריאת ה-ADC (‏0-4095) כפול 1.5.

## 2. Hands-free: רגישות ושקט

שני סליידרים, ליד מתג ה-Hands-free:

| סליידר | מה הוא קובע | מתי לשנות |
|---|---|---|
| Sensitivity (1-5) | כמה חזק צריך לדבר יחסית לרעש הרקע | הלוח לא שומע דיבור שקט: להעלות. רעשים בחדר מפעילים אותו: להוריד |
| Stop after silence (0.6-1.5 שניות) | כמה שקט מסיים משפט | המשפט נחתך בהפסקה קצרה: להאריך. הוא מחכה יותר מדי אחרי שסיימתם: לקצר |

**איך מכיילים בחדר:**
1. מדליקים Hands-free ולא מדברים 10 שניות. במד העוצמה רואים את רעש הרקע ואת הסף.
2. אומרים משפט רגיל מהמקום שבו המשתמש יעמוד. הוא צריך להתחיל להקליט מהמילה הראשונה.
3. דופקים על השולחן ומוחאים כף. זה לא צריך להתחיל הקלטה. אם זה כן, מורידים רגישות בדרגה אחת.
4. אומרים משפט עם הפסקה באמצע. אם הוא נחתך, מאריכים את Stop after silence.

**כיול בלי הלוח:** הכלי `tools/vad_replay.cpp` מריץ את אותו גלאי על הקלטות WAV במחשב (למשל הקלטות שהורדו מה-SD), ומראה איפה הוא היה מתחיל ועוצר בכל רגישות. ההוראות בראש הקובץ.

## 3. עוצמת המיקרופון

ההגברה של המיקרופון קבועה בקוד: `kMicSoftwareGain = 2` ב-`ESP32/parameters.h`. ב-x4 דיבור רגיל הגיע לקיטום.

**בדיקה:** בזמן הקלטה, מד העוצמה במרכז הבקרה (`@@MIC_LEVEL`) צריך להגיע בדיבור רגיל מחצי מטר לסביבות ‎-20 dBFS. במדידות שלנו החציון היה ‎-19 dBFS, וקיטום הופיע בשאלה אחת מתוך 26. אם יש הרבה קיטום (הערך קרוב ל-0), מורידים ל-1. אם הכל חלש מ-‎-35, מעלים ל-3. מרכז הבקרה מקבל את ההגברה מהלוח בשורת `@@LIMITS` (`mic_gain`), כך שהניגון של ההקלטות במחשב נשמע כמו מה ש-OpenAI שמע בלי לעדכן שום דבר בדף.

</div>
