tomer-gilan/Technion_Voice_Assistant_Summer_2026_A2/Documentation/measurements/latency-vad-analysis.md

## Performance measurements

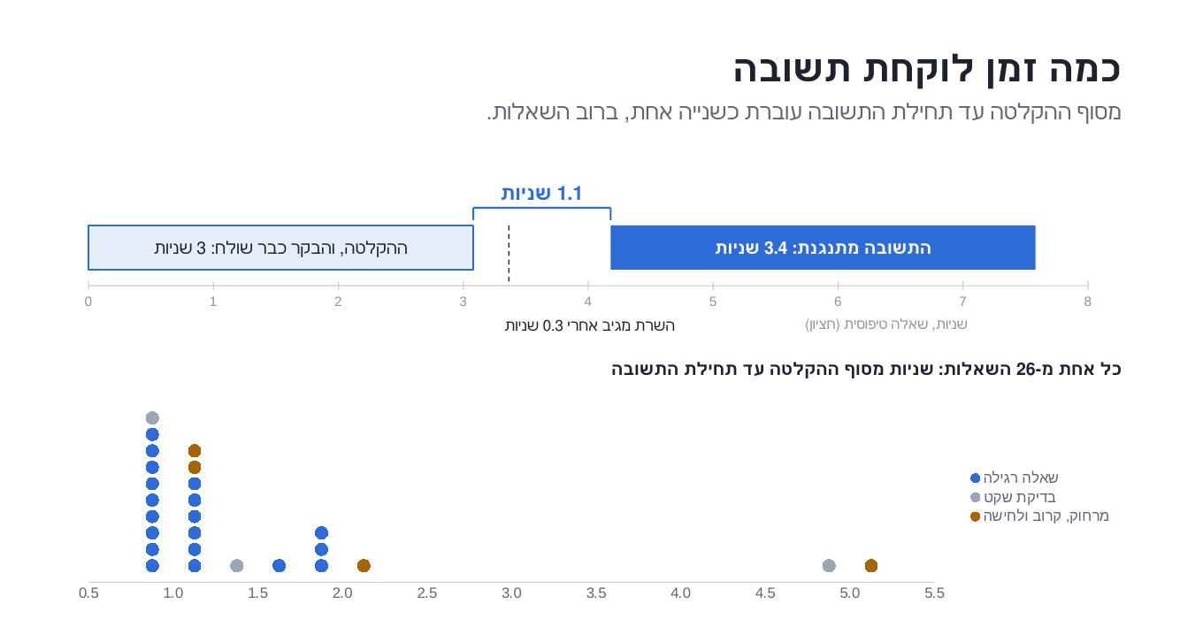
[picture p12: Documentation/images/response-time.png]
Response time


| What | Result |
|---|---|
| Questions that finished successfully | 26 of 26 |
| From the end of the recording to the first message from the server (median) | About 0.3 seconds |
| From the end of the recording to the first sound of the answer (median) | About 1.1 seconds |
| Questions where the answer started in under 2 seconds | 23 of 26 (the slow ones, about 5 seconds, were quiet speech and speech from far away) |
| From the request `Turn on the light` until the LED turned on | 0.97 seconds (the spoken confirmation started after 1.9 seconds) |
| Full boot (until ready to talk) | 6.8 / 9.1 / 10.8 seconds |
| The longest stage of the boot | The encrypted connection to OpenAI, 3.9 to 5.1 seconds |

The statistics panel

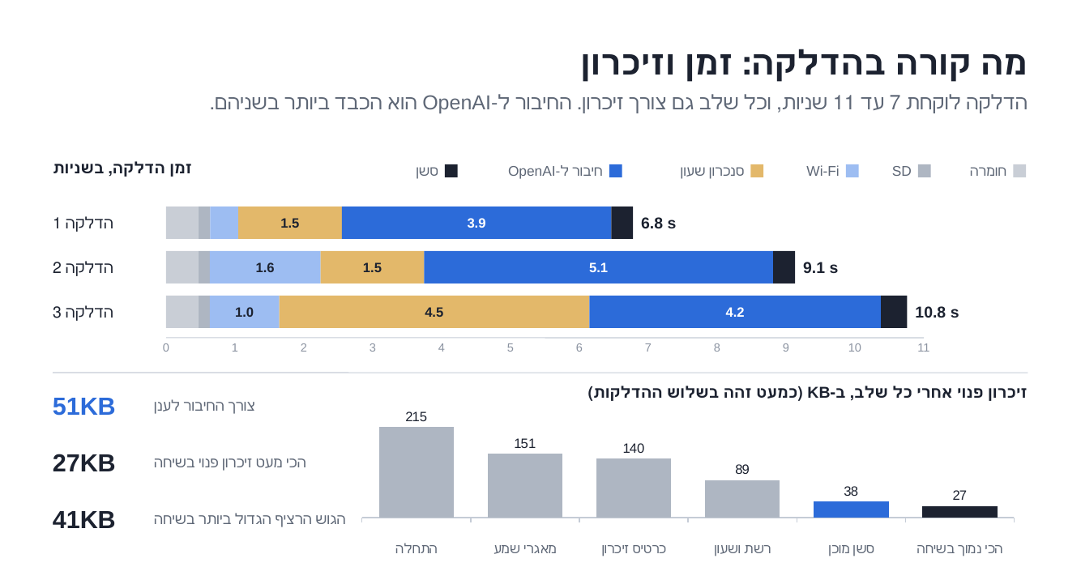
[picture p13: Documentation/images/boot-and-memory.png]
Boot and memory


| Memory (heap) | |
|---|---|
| Free at boot | 215KB |
| Free when the session is ready | 38KB |
| Free during a conversation | About 45KB, stable over 26 questions (no leak) |
| Least free during a conversation | 27KB |
| The largest consumer | The encrypted connection and the WebSocket, about 51KB |
| Firmware size (the current version) | 1.08MB, 82% of the flash |
| Static RAM (global variables) | 75KB of 320KB |

| Audio | |
|---|---|
| Microphone level, normal speech (median) | -19 dBFS |
| Close / far / whisper | -17 / -30 / -32 dBFS |
| Clipping | In 1 question of 26 |
| Sent to the cloud per question | About 193KB (PCM at 24kHz, 384 kbps) |
| The answer's audio | mu-law at 8kHz, 64 kbps |

### The voice detector of Hands-free mode

The voice detector (`vad_utils`) compares the energy in the speech frequency band with the room noise, and also checks whether the sound is "voiced" and whether it has a syllable rhythm. 

We have made an experiment testing its robustness:

the experiment consisted of:

**7 tries no background noise, from 30cm**: https://drive.google.com/file/d/15XqPF-qTp5h3Js5RfgU-yO7ZWNuI14x2/view?usp=sharing

**7 tries no background noise, from 1m**: https://drive.google.com/file/d/1_J4KRvmbBdHWHWzz8-GxnjN1snCDVA2i/view?usp=sharing

**7 tries no background noise, from 3m**: https://drive.google.com/file/d/1bafFgYCVepoukUZTQFGe9seul2shS6F6/view?usp=sharing

**7 tries with background knocking noise, from 1m**: https://drive.google.com/file/d/1ZO0dkavtI3zt9yy6JgWnE4jvzhyE8G6y/view?usp=sharing

#### Results

| Condition | Distance | Background noise | Tries | Successful | Video |
|---|---|---|---|---|---|
| Quiet | 30 cm | None | 7 | **7/7** | [link](https://drive.google.com/file/d/15XqPF-qTp5h3Js5RfgU-yO7ZWNuI14x2/view?usp=sharing) |
| Quiet | 1 m | None | 7 | **7/7** | [link](https://drive.google.com/file/d/1_J4KRvmbBdHWHWzz8-GxnjN1snCDVA2i/view?usp=sharing) |
| Quiet | 3 m | None | 7 | **7/7** | [link](https://drive.google.com/file/d/1bafFgYCVepoukUZTQFGe9seul2shS6F6/view?usp=sharing) |
| Noisy | 1 m | Knocking on the table | 7 | **6/7** | [link](https://drive.google.com/file/d/1ZO0dkavtI3zt9yy6JgWnE4jvzhyE8G6y/view?usp=sharing) |
| **Total** | | | **28** | **27/28 (96%)** | |

A try counts as successful when the detector started recording on its own, ended it when the speaker stopped, and the assistant carried out the command.

**Conclusion:** in a quiet room the detector caught every sentence, even from 3 m. With knocking in the background it missed one try out of 7 - the noise raises the room's background level, so the speech stands out less above it. This matches our assumption in [decisions.md](../development_steps/decisions.md): Hands-free works best in a relatively quiet room, which is why Talk and the BOOT button always stay available.
