tomer-gilan/Technion_Voice_Assistant_Summer_2026_A2/docs/edge-cases-v3.pdf

# מקרי קצה · עוזר קולי על 32ESP קבוצה 2A · קורס IoT · קיץ 2026

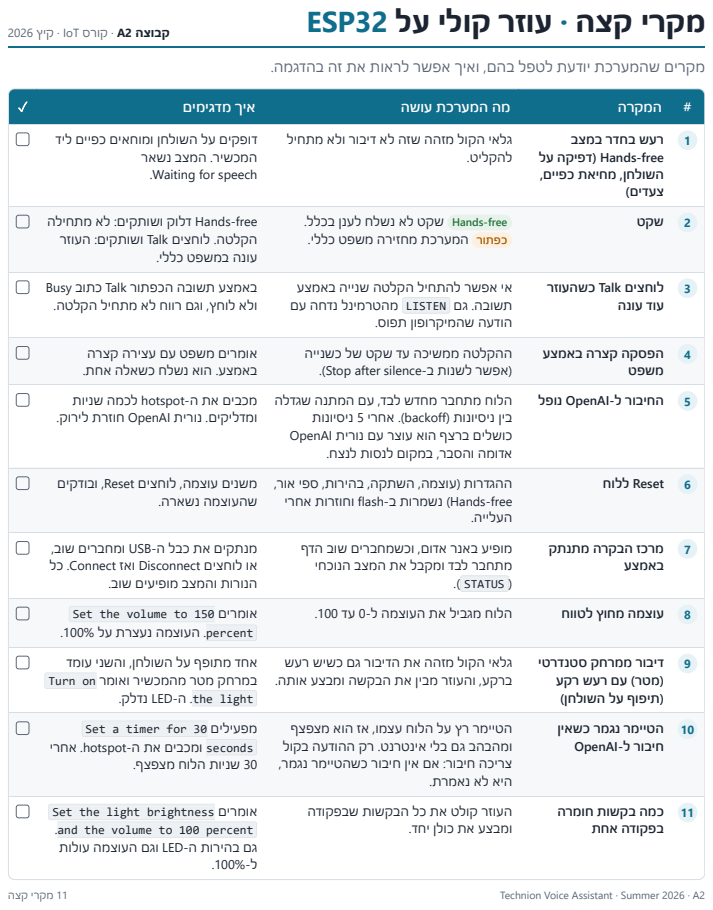
[picture p17: page 1]
צעדים(; להקליט.; עוד עונה; משפט; העלייה.; שהעוצמה נשארה.; באמצע; .) STATUS (; נדלק; LED-ה .the light; Set a timer for 30; מפעילים; Set the light brightness; אומרים; קצה; מקרי; Technion Voice Assistant · Summer 2026 · A2

מקרים שהמערכת יודעת לטפל בהם, ואיך אפשר לראות את זה בהדגמה.

# המקרה מה המערכת עושה איך מדגימים ✓

דופקים על השולחן ומוחאים כפיים ליד

גלאי הקול מזהה שזה לא דיבור ולא מתחיל

1 רעש בחדר במצב
free-Hands( דפיקה על
השולחן, מחיאת כפיים,

המכשיר. המצב נשאר
.Waiting for speech

free-Hands דלוק ושותקים: לא מתחילה
הקלטה. לוחצים Talk ושותקים: העוזר

2 שקט free-Hands שקט לא נשלח לענן בכלל.
כפתור המערכת מחזירה משפט כללי.

עונה במשפט כללי.

באמצע תשובה הכפתור Talk כתוב Busy
ולא לוחץ, וגם רווח לא מתחיל הקלטה.

אי אפשר להתחיל הקלטה שנייה באמצע
תשובה. גם LISTEN מהטרמינל נדחה עם

3 לוחצים Talk כשהעוזר

הודעה שהמיקרופון תפוס.

אומרים משפט עם עצירה קצרה
באמצע. הוא נשלח כשאלה אחת.
מכבים את ה-hotspot לכמה שניות
ומדליקים. נורית OpenAI חוזרת לירוק.

ההקלטה ממשיכה עד שקט של כשנייה
)אפשר לשנות ב-silence after Stop).
5 החיבור ל-OpenAI נופל הלוח מתחבר מחדש לבד, עם המתנה שגדלה
בין ניסיונות )backoff). אחרי 5 ניסיונות
כושלים ברצף הוא עוצר עם נורית OpenAI
אדומה והסבר, במקום לנסות לנצח.

4 הפסקה קצרה באמצע

משנים עוצמה, לוחצים Reset, ובודקים

6 Reset ללוח ההגדרות )עוצמה, השתקה, בהירות, ספי אור,
free-Hands )נשמרות ב-flash וחוזרות אחרי

מנתקים את כבל ה-USB ומחברים שוב,
או לוחצים Disconnect ואז Connect. כל

מופיע באנר אדום, וכשמחברים שוב הדף
מתחבר לבד ומקבל את המצב הנוכחי

7 מרכז הבקרה מתנתק

הנורות והמצב מופיעים שוב.
8 עוצמה מחוץ לטווח הלוח מגביל את העוצמה ל0- עד .100 אומרים 150 to volume the Set
percent. העוצמה נעצרת על .100%
אחד מתופף על השולחן, והשני עומד
במרחק מטר מהמכשיר ואומר on Turn

גלאי הקול מזהה את הדיבור גם כשיש רעש
ברקע, והעוזר מבין את הבקשה ומבצע אותה.

9 דיבור ממרחק סטנדרטי
)מטר( עם רעש רקע
)תיפוף על השולחן(
10 הטיימר נגמר כשאין
חיבור ל-OpenAI

seconds ומכבים את ה-hotspot. אחרי

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

30 שניות הלוח מצפצף.

היא לא נאמרת.

.and the volume to 100 percent
גם בהירות ה-LED וגם העוצמה עולות

העוזר קולט את כל הבקשות שבפקודה

11 כמה בקשות חומרה
בפקודה אחת

ומבצע את כולן יחד.
