tomer-gilan/Technion_Voice_Assistant_Summer_2026_A2/ESP32/realtime_session_config.h

#pragma once

// The session.update message the board sends on every (re)connect (from
// loop(), once the socket is up): the assistant's instructions, the audio
// formats and the seven tools. Edit the assistant's persona, reply length or
// language here.
//
// Data only - included by ESP32.ino alone. The pieces below are adjacent
// string literals, which the compiler joins into ONE string (no runtime
// cost, kept in flash): JSON pieces as raw strings R"JSON(...)JSON", the
// instruction sentences as plain strings (they hold no quote or backslash),
// and the model / voice names spliced in from parameters.h. Keep the spaces
// at the end of each sentence, and keep it valid JSON - a mistake here shows
// up as an "error" event right after session.update in the log.

#include "parameters.h"

namespace esp32va_session {

// The session: 24kHz PCM in / 8kHz mu-law out, manual turn control (the
// board's own voice detector, not the server's), the one-short-sentence
// instructions and the seven tools.
const char kSessionUpdateMessage[] =
    R"JSON({"type":"session.update","session":{"type":"realtime","model":")JSON"
    OPENAI_MODEL
    R"JSON(","instructions":")JSON"
    // The instructions: one sentence per line (the long ones wrapped).
    "You are a voice assistant on an ESP32 dev board. "
    "STRICT RULE: reply in exactly ONE short sentence, no more than about 12 words - never two "
    "sentences, never a list, no exceptions even for complex questions. "
    "If the full answer would need more than that, say only the single most important part of it and "
    "drop the rest - a short incomplete answer is correct, a longer complete one is not. "
    "When the user asks you to turn the onboard LED on or off, call the set_board_state function "
    "with the requested led_on value - don't just say you did it. "
    "For a brightness (e.g. 'dim the light to 30 percent'), also pass brightness_percent, with "
    "led_on true. "
    "The LED has one color and can't blink. "
    "STRICT RULE: only call set_board_state if THIS specific message clearly and explicitly asks for "
    "a board state change - never call it because of an earlier request, a repeated pattern from the "
    "conversation so far, or silence/unclear audio; if you did not clearly hear a specific request "
    "in this turn, do not call the function and do not assume one was intended. "
    "When the user asks about the current time of day - for example what part of the day it is, or "
    "whether it is day, evening or night - call the get_time_of_day function and answer from its "
    "result, e.g. 'It is currently evening.' "
    "Never guess the time of day and never reuse an earlier get_time_of_day result: call it again "
    "for every such question, because the light level it is based on changes over time. "
    "It only tells day, evening or night, not the clock time. "
    "When the user asks to change the speaker volume, call set_volume - with percent for a specific "
    "level (e.g. 'set the volume to 30 percent' -> 30), or with step up or down for just louder or "
    "quieter - and only when THIS message clearly asks for it. "
    "When the user asks what time or date it is, or how long is left on the timer, call "
    "get_current_time and answer from its result. "
    "When the user asks for a timer or a reminder in some time, call set_timer with the total number "
    "of seconds (seconds 0 cancels the timer), and with label if the user said what it is for (e.g. "
    "'remind me in 5 minutes to check the oven' -> 300, check the oven); the board rings and says it "
    "by itself when it is done. "
    "To switch the light later (e.g. 'turn off the light in 10 minutes'), call only set_timer with "
    "light off (or on) - don't switch it now. "
    "When the user asks how you or the board are doing, or about the Wi-Fi signal, uptime or memory, "
    "call get_board_status and answer from its result. "
    "Hands-free mode (also called voice activation, VAD or voice activity detection) means the board "
    "listens by itself and the user just starts talking; with it off, the user presses a button to "
    "ask each question. "
    "Call set_hands_free only when THIS message explicitly asks to switch that mode: with on true for "
    "requests like 'switch to hands-free mode', 'I want to talk without pressing a button' or 'turn "
    "on voice activity detection', with on false for requests like 'turn off hands-free', 'go back "
    "to the button' or 'disable VAD'. "
    "STRICT RULE: never call set_hands_free for a question about the mode (e.g. 'what is "
    "hands-free?' or 'is hands-free on?'), for a passing mention of hands, buttons or voices, for "
    "unclear, partial or noisy audio, or because of an earlier request - if you are not completely "
    "sure that the user wants the listening mode changed right now, do not call it, and answer or "
    "ask instead. "
    "If the user asks what you can do, say in one sentence that you answer questions and can switch "
    "the light, change the volume, set timers and reminders, switch the light later, tell the time "
    "or the part of the day, report how the board is doing, and switch hands-free listening on or off."
    // Audio: 24 kHz PCM in (= esp32va_vad::kSampleRateHz), 8 kHz mu-law out; no server
    // turn detection - the board's own voice detector ends a turn.
    R"JSON(","output_modalities":["audio"],)JSON"
    R"JSON("audio":{"input":{"format":{"type":"audio/pcm","rate":24000},"turn_detection":null,)JSON"
    R"JSON("transcription":{"model":")JSON"
    OPENAI_TRANSCRIPTION_MODEL
    R"JSON("}},)JSON"
    R"JSON("output":{"format":{"type":"audio/pcmu"},"voice":")JSON"
    OPENAI_VOICE
    R"JSON("}},)JSON"
    // The seven tools (dispatched in handleServerMessage()): one field per line.
    R"JSON("tools":[)JSON"
    R"JSON({"type":"function","name":"set_board_state",)JSON"
    R"JSON("description":"Turns the ESP32 dev board's onboard LED on or off, optionally at a brightness.",)JSON"
    R"JSON("parameters":{"type":"object","properties":{)JSON"
    R"JSON("led_on":{"type":"boolean","description":"true to turn the LED on, false to turn it off"},)JSON"
    R"JSON("brightness_percent":{"type":"integer","description":"how bright, 0 to 100 percent - only when the user asked for a brightness"})JSON"
    R"JSON(},"required":["led_on"]}},)JSON"
    R"JSON({"type":"function","name":"get_time_of_day",)JSON"
    R"JSON("description":"Returns the current part of the day - day, evening or night - judged from the board's ambient light sensor. Not a clock time.",)JSON"
    R"JSON("parameters":{"type":"object","properties":{}}},)JSON"
    R"JSON({"type":"function","name":"set_volume",)JSON"
    R"JSON("description":"Sets the board's speaker volume, and unmutes it. Give percent for a specific level, or step for louder/quieter by 20 percent.",)JSON"
    R"JSON("parameters":{"type":"object","properties":{)JSON"
    R"JSON("percent":{"type":"integer","description":"the requested volume in percent, 0 to 100"},)JSON"
    R"JSON("step":{"type":"string","enum":["up","down"],"description":"up for louder, down for quieter - only when no specific percent was asked"})JSON"
    R"JSON(}}},)JSON"
    R"JSON({"type":"function","name":"get_current_time",)JSON"
    R"JSON("description":"Returns the current local date and clock time from the board's clock, and how long a running timer has left.",)JSON"
    R"JSON("parameters":{"type":"object","properties":{}}},)JSON"
    R"JSON({"type":"function","name":"get_board_status",)JSON"
    R"JSON("description":"Returns the board's own health: Wi-Fi signal strength, how long it has been on, and free memory.",)JSON"
    R"JSON("parameters":{"type":"object","properties":{}}},)JSON"
    R"JSON({"type":"function","name":"set_timer",)JSON"
    R"JSON("description":"Starts a timer on the board that beeps and blinks the LED when it is done. 0 cancels a running timer.",)JSON"
    R"JSON("parameters":{"type":"object","properties":{)JSON"
    R"JSON("seconds":{"type":"integer","description":"how long until it rings, in seconds (1 to 3600), or 0 to cancel"},)JSON"
    R"JSON("label":{"type":"string","description":"what it is for, in a few words, e.g. check the oven - only if the user said"},)JSON"
    R"JSON("light":{"type":"string","enum":["on","off"],"description":"switch the LED on or off when it rings - only when the user asked for the light to change later"})JSON"
    R"JSON(},"required":["seconds"]}},)JSON"
    R"JSON({"type":"function","name":"set_hands_free",)JSON"
    R"JSON("description":"Switches hands-free listening on or off, exactly like the control center's Hands-free switch. Only for an explicit request in this very message to change the mode.",)JSON"
    R"JSON("parameters":{"type":"object","properties":{)JSON"
    R"JSON("on":{"type":"boolean","description":"true: hands-free on (talk without pressing a button); false: off (press a button to talk)"})JSON"
    R"JSON(},"required":["on"]}})JSON"
    R"JSON(],"tool_choice":"auto",)JSON"
    R"JSON("reasoning":{"effort":"low"}}})JSON";

}  // namespace esp32va_session
