tomer-gilan/Technion_Voice_Assistant_Summer_2026_A2/ESP32/i2s_audio_utils.cpp

#include "i2s_audio_utils.h"

#include <Arduino.h>
#include <driver/i2s.h>
#include <math.h>
#include <mbedtls/base64.h>
#include "parameters.h"
#include "log_utils.h"
#include "status_report_utils.h"
#include "vad_utils.h"

namespace esp32va_audio {

namespace {
constexpr i2s_port_t kI2sPort = I2S_NUM_0;
constexpr uint32_t kSampleRateHz = esp32va_vad::kSampleRateHz;  // the mic's 24 kHz, defined once (vad_utils.h)
constexpr uint32_t kI2sDmaBufLen = 300;
constexpr uint32_t kI2sDmaBufCount = 12;  // 12*300 = 3600 samples of ring capacity

// Holds raw mu-law bytes (NOT decoded PCM) - see header comment. At
// 8kHz/1 byte-per-sample, 32KB is ~4.1s of audio. Halved from 64KB in step
// 24: with the SD card mounted, 64KB left only ~9KB free once the OpenAI
// session was up, and the first reply/LISTEN ran the heap dry. A 48KB
// midpoint was tried too, but 32KB was kept to leave RAM for future
// features (see Documentation/decisions.md step 24). Backpressure, not buffer
// size, is what paces long replies - a smaller ring only shrinks the
// cushion against network stalls.
constexpr uint32_t kRingBufferBytes = 32 * 1024;
// Pause reading more from the WebSocket once free space drops below 30%,
// resume once it's back above 60% (hysteresis). 30% of 32KB is ~1.2s of
// headroom when pausing kicks in - still more than what can already be in
// flight (one ~0.4s delta being decoded plus a TCP receive window's worth).
constexpr uint32_t kRingPauseThresholdBytes = (kRingBufferBytes * 3) / 10;
constexpr uint32_t kRingResumeThresholdBytes = (kRingBufferBytes * 6) / 10;

// Per-pass base64 decode size, aligned to base64's 4-character grouping -
// caps how much of one delta gets decoded at a time, regardless of how large
// the delta itself is.
constexpr uint32_t kDecodeInputChars = 1024;
constexpr uint32_t kDecodeOutputBufBytes = 800;  // >= 1024/4*3 = 768 decoded mu-law bytes
// mu-law is 8kHz; the shared full-duplex I2S peripheral runs at kSampleRateHz
// (24kHz) - repeat each decoded sample this many times.
constexpr int kOutputUpsampleFactor = 3;
// Drained from the ring to the speaker per call, in raw mu-law bytes - 320
// bytes = 40ms of source audio (960 samples once upsampled), a deliberately
// small chunk so i2s_write()'s blocking wait for DMA space stays short.
constexpr uint32_t kTxDrainMuLawBytes = 320;

uint8_t* ring_buffer = nullptr;
uint32_t ring_write_index = 0;
uint32_t ring_read_index = 0;
uint32_t ring_used_bytes = 0;

bool ring_lent_to_mic = false;  // see lendRingToMic()

bool recording_tap_active = false;
uint32_t recording_tap_read_index = 0;
uint32_t recording_tap_pending_bytes = 0;

// Speaker volume as a Q12 fixed-point multiplier (4096 = full scale, as
// before step 28). Set from a 0-100% slider through a square curve, so the
// slider feels even to the ear rather than all happening in its top third.
constexpr int32_t kVolumeUnityQ12 = 4096;
constexpr int32_t kMaxVolumePercent = 100;
int32_t playback_volume_q12 = kVolumeUnityQ12;

// Startup mic check: skip the first part (the INMP441 needs ~85 ms after its
// clock starts before its data is valid), then measure.
constexpr uint32_t kMicCheckSettleSamples = kSampleRateHz / 5;   // 200 ms
constexpr uint32_t kMicCheckMeasureSamples = kSampleRateHz / 5;  // 200 ms
constexpr uint32_t kMicCheckReadSamples = 240;                   // 10 ms per i2s_read
int32_t mic_check_scratch[kMicCheckReadSamples];

// Test beep: a short, clearly audible tone, well below full scale.
constexpr uint32_t kBeepFrequencyHz = 880;
constexpr uint32_t kBeepDurationMs = 300;
constexpr int32_t kBeepAmplitude = 8000;

uint8_t decode_scratch[kDecodeOutputBufBytes];
uint8_t tx_mulaw_bytes[kTxDrainMuLawBytes];
int32_t tx_i2s_words[kTxDrainMuLawBytes * kOutputUpsampleFactor];

constexpr int kUlawBias = 0x84;
constexpr int kUlawClip = 32635;  // the largest magnitude mu-law encodes; louder is clipped to it
}  // namespace

uint8_t linearPcm16ToUlaw(int16_t sample) {
  int sign = sample < 0 ? 0x80 : 0;
  int magnitude = sample < 0 ? -static_cast<int>(sample) : sample;
  if (magnitude > kUlawClip) {
    magnitude = kUlawClip;
  }
  magnitude += kUlawBias;
  int exponent = 7;
  for (int mask = 0x4000; (magnitude & mask) == 0 && exponent > 0; mask >>= 1) {
    exponent--;
  }
  int mantissa = (magnitude >> (exponent + 3)) & 0x0F;
  return static_cast<uint8_t>(~(sign | (exponent << 4) | mantissa));
}

int16_t ulawToLinearPcm16(uint8_t ulaw_sample) {
  uint8_t inverted = ~ulaw_sample;
  int magnitude = ((inverted & 0x0F) << 3) + kUlawBias;
  magnitude <<= (inverted & 0x70) >> 4;
  return static_cast<int16_t>((inverted & 0x80) ? (kUlawBias - magnitude) : (magnitude - kUlawBias));
}

void setupI2sFullDuplex() {
  i2s_config_t i2s_config = {
    .mode = static_cast<i2s_mode_t>(I2S_MODE_MASTER | I2S_MODE_TX | I2S_MODE_RX),
    .sample_rate = kSampleRateHz,
    .bits_per_sample = I2S_BITS_PER_SAMPLE_32BIT,  // INMP441 sends 24-bit data in a 32-bit frame; TX bus matches width
    .channel_format = I2S_CHANNEL_FMT_ONLY_RIGHT,  // confirmed in step 3 for this board's mic
    .communication_format = I2S_COMM_FORMAT_STAND_I2S,
    .intr_alloc_flags = ESP_INTR_FLAG_LEVEL1,
    .dma_buf_count = kI2sDmaBufCount,
    .dma_buf_len = kI2sDmaBufLen,
    .use_apll = false,
    .tx_desc_auto_clear = true,  // auto-fills silence between writes, avoiding TX buffer underrun noise
    .fixed_mclk = 0,
    .mclk_multiple = I2S_MCLK_MULTIPLE_DEFAULT,
    .bits_per_chan = I2S_BITS_PER_CHAN_DEFAULT
  };

  i2s_pin_config_t pin_config = {
    // No master clock pin: neither the INMP441 nor the MAX98357A uses MCLK.
    // Left out, this field was 0 - and the driver then put MCLK out on
    // GPIO0, the BOOT button's pin.
    .mck_io_num = I2S_PIN_NO_CHANGE,
    .bck_io_num = I2S_BCLK,             // shared clock line, also wired to the mic
    .ws_io_num = I2S_LRC,               // shared clock line, also wired to the mic
    .data_out_num = I2S_DOUT,           // to MAX98357A DIN
    .data_in_num = I2S_MIC_SERIAL_DATA  // from INMP441 SD
  };

  esp_err_t install_result = i2s_driver_install(kI2sPort, &i2s_config, 0, nullptr);
  if (install_result != ESP_OK) {
    // Continuing to i2s_set_pin() after a failed install previously caused a
    // Guru Meditation crash-reboot loop for this exact driver (old step 8b).
    LOG_ERROR("i2s_driver_install failed (code %d) - halting.\n", (int)install_result);
    esp32va_status::reportStage(esp32va_status::Stage::kMicrophone, esp32va_status::StageState::kFail,
                                "audio driver failed to start - board halted");
    esp32va_status::reportStage(esp32va_status::Stage::kSpeaker, esp32va_status::StageState::kFail,
                                "audio driver failed to start - board halted");
    esp32va_status::reportPipelineState(esp32va_status::PipelineState::kHalted, "audio driver failed to start");
    while (true) delay(1000);
  }
  i2s_set_pin(kI2sPort, &pin_config);
}

bool checkMicrophoneSignal(char* detail_out, size_t detail_size) {
  uint32_t samples_seen = 0;
  uint32_t samples_measured = 0;
  int16_t lowest = INT16_MAX;
  int16_t highest = INT16_MIN;
  double sum = 0.0;
  double sum_of_squares = 0.0;
  while (samples_seen < kMicCheckSettleSamples + kMicCheckMeasureSamples) {
    size_t bytes_read = 0;
    i2s_read(kI2sPort, mic_check_scratch, sizeof(mic_check_scratch), &bytes_read, portMAX_DELAY);
    uint32_t samples_read = bytes_read / sizeof(int32_t);
    for (uint32_t i = 0; i < samples_read; i++, samples_seen++) {
      if (samples_seen < kMicCheckSettleSamples) continue;
      int16_t sample = static_cast<int16_t>(mic_check_scratch[i] >> 16);
      lowest = min(lowest, sample);
      highest = max(highest, sample);
      sum += sample;
      sum_of_squares += static_cast<double>(sample) * sample;
      samples_measured++;
    }
  }

  if (samples_measured == 0 || lowest == highest) {
    snprintf(detail_out, detail_size, "no signal - stuck at %d. Check the mic's wires and power", (int)lowest);
    LOG_ERROR("Mic check failed: every sample read %d - the mic isn't sending audio.\n", (int)lowest);
    return false;
  }
  // Level around the mean, so the mic's own DC offset doesn't count as sound.
  double mean = sum / samples_measured;
  double variance = sum_of_squares / samples_measured - mean * mean;
  double rms = variance > 0.0 ? sqrt(variance) : 0.0;
  double level_dbfs = rms > 0.0 ? 20.0 * log10(rms / 32768.0) : -96.0;
  snprintf(detail_out, detail_size, "signal OK, room level %.0f dBFS", level_dbfs);
  LOG_INFO("Mic check passed - room level %.1f dBFS (samples %d to %d).\n", level_dbfs, (int)lowest, (int)highest);
  return true;
}

void setPlaybackVolume(uint8_t percent, bool muted) {
  int32_t clamped = min(static_cast<int32_t>(percent), kMaxVolumePercent);
  playback_volume_q12 = muted ? 0 : clamped * clamped * kVolumeUnityQ12 / (kMaxVolumePercent * kMaxVolumePercent);
}

void playTestBeep() {
  playTone(kBeepFrequencyHz, kBeepDurationMs);
}

void playTone(uint32_t frequency_hz, uint32_t duration_ms) {
  const uint32_t total_samples = kSampleRateHz * duration_ms / 1000;
  constexpr uint32_t kChunkWords = sizeof(tx_i2s_words) / sizeof(tx_i2s_words[0]);
  uint32_t samples_written = 0;
  while (samples_written < total_samples) {
    uint32_t words = min(kChunkWords, total_samples - samples_written);
    for (uint32_t i = 0; i < words; i++) {
      double phase = 2.0 * M_PI * frequency_hz * (samples_written + i) / kSampleRateHz;
      int32_t sample = static_cast<int32_t>(kBeepAmplitude * sin(phase)) * playback_volume_q12 / kVolumeUnityQ12;
      tx_i2s_words[i] = sample << 16;  // same 32-bit-wide TX alignment as drainRingBufferToSpeaker()
    }
    size_t bytes_written = 0;
    i2s_write(kI2sPort, tx_i2s_words, words * sizeof(int32_t), &bytes_written, portMAX_DELAY);
    samples_written += words;
  }
}

void waitUntilPlayedOut() {
  // At most the DMA buffers' worth of audio is queued after playTone()
  // returns. The margin: the mic task reads 20 ms frames, a DMA buffer behind.
  constexpr uint32_t kPlayedOutMarginMs = 40;
  delay(kI2sDmaBufCount * kI2sDmaBufLen * 1000 / kSampleRateHz + kPlayedOutMarginMs);
}

uint32_t micBufferCapacityMs() {
  return kI2sDmaBufCount * kI2sDmaBufLen * 1000 / kSampleRateHz;
}

uint32_t readMicChunkGained(int32_t* raw_scratch, int16_t* pcm_out, uint32_t max_samples, int32_t gain,
                             int16_t* level_min, int16_t* level_max, double* level_sum_of_squares) {
  size_t bytes_read = 0;
  i2s_read(kI2sPort, raw_scratch, max_samples * sizeof(int32_t), &bytes_read, portMAX_DELAY);
  uint32_t samples_read = bytes_read / sizeof(int32_t);

  for (uint32_t i = 0; i < samples_read; i++) {
    int16_t sample16 = static_cast<int16_t>(raw_scratch[i] >> 16);
    int32_t scaled = static_cast<int32_t>(sample16) * gain;
    if (scaled > INT16_MAX) scaled = INT16_MAX;
    if (scaled < INT16_MIN) scaled = INT16_MIN;
    pcm_out[i] = static_cast<int16_t>(scaled);
    *level_min = min(*level_min, pcm_out[i]);
    *level_max = max(*level_max, pcm_out[i]);
    *level_sum_of_squares += static_cast<double>(pcm_out[i]) * pcm_out[i];
  }
  return samples_read;
}

void readMicSamples(int32_t* raw_scratch, int16_t* samples_out, uint32_t sample_count) {
  size_t bytes_read = 0;
  i2s_read(kI2sPort, raw_scratch, sample_count * sizeof(int32_t), &bytes_read, portMAX_DELAY);
  uint32_t samples_read = bytes_read / sizeof(int32_t);
  for (uint32_t i = 0; i < samples_read; i++) {
    samples_out[i] = static_cast<int16_t>(raw_scratch[i] >> 16);
  }
  // portMAX_DELAY returns only once all of it arrived - this is just in case.
  for (uint32_t i = samples_read; i < sample_count; i++) {
    samples_out[i] = 0;
  }
}

void initPlaybackRingBuffer() {
  ring_buffer = static_cast<uint8_t*>(malloc(kRingBufferBytes));
  if (ring_buffer == nullptr) {
    LOG_ERROR("Failed to allocate %u-byte ring buffer - halting.\n", (unsigned)kRingBufferBytes);
    esp32va_status::reportStage(esp32va_status::Stage::kSpeaker, esp32va_status::StageState::kFail,
                                "no memory for the playback buffer - board halted");
    esp32va_status::reportPipelineState(esp32va_status::PipelineState::kHalted, "out of memory");
    while (true) delay(1000);
  }
}

void resetRingBuffer() {
  ring_write_index = 0;
  ring_read_index = 0;
  ring_used_bytes = 0;
  ringStopRecordingTap();
}

uint32_t ringUsedBytes() {
  return ring_used_bytes;
}

uint32_t ringFreeBytes() {
  uint32_t held_bytes = ring_used_bytes;
  if (recording_tap_active && recording_tap_pending_bytes > held_bytes) {
    held_bytes = recording_tap_pending_bytes;
  }
  return kRingBufferBytes - held_bytes;
}

void ringStartRecordingTap() {
  recording_tap_active = true;
  recording_tap_read_index = ring_write_index;
  recording_tap_pending_bytes = 0;
}

void ringStopRecordingTap() {
  recording_tap_active = false;
  recording_tap_pending_bytes = 0;
}

uint32_t ringRecordingTapPendingBytes() {
  return recording_tap_pending_bytes;
}

uint32_t ringReadRecordingTap(uint8_t* out, uint32_t max_len) {
  uint32_t n = min(max_len, recording_tap_pending_bytes);
  for (uint32_t i = 0; i < n; i++) {
    out[i] = ring_buffer[recording_tap_read_index];
    recording_tap_read_index = (recording_tap_read_index + 1) % kRingBufferBytes;
  }
  recording_tap_pending_bytes -= n;
  return n;
}

namespace {
/** Copies len bytes into the ring buffer, wrapping as needed. Drops (and
    logs) the whole segment rather than partially writing or blocking if it
    doesn't fit - a full ring means playback can't keep up with the network,
    which is worth knowing about, not silently smoothing over. */
void ringWrite(const uint8_t* data, uint32_t len) {
  if (len > ringFreeBytes()) {
    LOG_ERROR("Ring buffer overflow - dropping %u bytes of decoded audio.\n", (unsigned)len);
    return;
  }
  for (uint32_t i = 0; i < len; i++) {
    ring_buffer[ring_write_index] = data[i];
    ring_write_index = (ring_write_index + 1) % kRingBufferBytes;
  }
  ring_used_bytes += len;
  if (recording_tap_active) {
    recording_tap_pending_bytes += len;
  }
}

/** Copies up to max_len bytes out of the ring buffer into out, wrapping as
    needed. Returns how many bytes were actually available and copied. */
uint32_t ringRead(uint8_t* out, uint32_t max_len) {
  uint32_t n = min(max_len, ring_used_bytes);
  for (uint32_t i = 0; i < n; i++) {
    out[i] = ring_buffer[ring_read_index];
    ring_read_index = (ring_read_index + 1) % kRingBufferBytes;
  }
  ring_used_bytes -= n;
  return n;
}
}  // namespace

void decodeAndRingAudioDelta(const uint8_t* b64_data, size_t b64_len) {
  if (ring_lent_to_mic) {
    LOG_ERROR("Reply audio arrived while the mic was listening - dropped %u base64 characters of it.\n",
              (unsigned)b64_len);
    return;
  }
  size_t offset = 0;
  while (offset < b64_len) {
    size_t take = min((size_t)kDecodeInputChars, b64_len - offset);
    take -= take % 4;  // stay aligned to base64's 4-character groups
    if (take == 0) break;

    size_t decoded_len = 0;
    int result = mbedtls_base64_decode(decode_scratch, sizeof(decode_scratch), &decoded_len,
                                        b64_data + offset, take);
    if (result != 0) {
      LOG_ERROR("base64 decode failed (code %d) - dropping remainder of this delta.\n", result);
      return;
    }
    ringWrite(decode_scratch, decoded_len);
    offset += take;
  }
}

void drainRingBufferToSpeaker() {
  uint32_t n = ringRead(tx_mulaw_bytes, kTxDrainMuLawBytes);
  if (n == 0) return;

  uint32_t word_index = 0;
  for (uint32_t i = 0; i < n; i++) {
    int32_t scaled = static_cast<int32_t>(ulawToLinearPcm16(tx_mulaw_bytes[i])) * playback_volume_q12 / kVolumeUnityQ12;
    int32_t widened = scaled << 16;  // re-align for the 32-bit-wide TX bus
    for (int rep = 0; rep < kOutputUpsampleFactor; rep++) {
      tx_i2s_words[word_index++] = widened;
    }
  }
  size_t bytes_written = 0;
  i2s_write(kI2sPort, tx_i2s_words, word_index * sizeof(int32_t), &bytes_written, portMAX_DELAY);
}

bool ringShouldPauseReads(bool currently_paused) {
  if (currently_paused) {
    return ringFreeBytes() <= kRingResumeThresholdBytes;
  }
  return ringFreeBytes() < kRingPauseThresholdBytes;
}

uint8_t* lendRingToMic(uint32_t* capacity_samples) {
  if (ring_buffer == nullptr || ring_used_bytes > 0 || recording_tap_active) {
    return nullptr;
  }
  if (!ring_lent_to_mic) {
    resetRingBuffer();
    ring_lent_to_mic = true;
  }
  *capacity_samples = kRingBufferBytes;  // one mu-law byte per sample
  return ring_buffer;
}

void returnRingFromMic() {
  if (!ring_lent_to_mic) {
    return;
  }
  ring_lent_to_mic = false;
  resetRingBuffer();  // the mic's samples aren't audio to play
}

bool isRingLentToMic() {
  return ring_lent_to_mic;
}

}  // namespace esp32va_audio
