tomer-gilan/Technion_Voice_Assistant_Summer_2026_A2/ESP32/sd_card_utils.h

#pragma once

#include <stddef.h>

// SD card over SPI (pins from parameters.h): mounting it with as little RAM as
// possible, plus a write/read-back self-test proving the card actually
// works rather than just mounted. Uses the ESP32 core's own SD library, so
// once mounted, paths given to SD.open()/SD.remove() etc. are relative to
// the card's root (e.g. "/replies/reply_0001.ulaw"), while POSIX calls
// (open()/opendir()/stat()) need kSdMountPoint in front.

namespace esp32va_sd_card {

/** Where the card's filesystem is mounted in the ESP32's virtual filesystem. */
constexpr char kSdMountPoint[] = "/sd";

/** Starts the SPI bus on parameters.h's SD pins and mounts the card's FAT
    filesystem with a single open-file slot (see kMaxOpenFiles in the .cpp
    for why). Logs the card type, its size, and how much heap the mount
    cost. Returns false (logged) if no card responds or it can't be mounted.
    Call once from setup(), before Wi-Fi/TLS have fragmented the heap. */
bool mountSdCard();

/** Writes a short test file, reads it back, compares, and deletes it.
    Returns true only if every step worked and the contents matched; logs
    which step failed otherwise. Call only after mountSdCard() succeeded. */
bool runSdSelfTest();

/** Writes e.g. "SDHC/SDXC, 7580 MB" - the mounted card's type and size -
    into out, for the laptop app's SD card badge. Call only after
    mountSdCard() succeeded. */
void describeSdCard(char* out, size_t out_size);

/** Records whether the card passed mounting, its self-test and the
    recorders' setup. Without a usable card the board runs on without
    recordings: the recorders skip their file work and LIST / GET / DELETE
    answer with an error line. Call once from setup(). */
void setSdCardUsable(bool usable);

/** True when the card passed every startup check (setSdCardUsable()) and
    hasn't been found gone since (serviceCardCheck()). */
bool isSdCardUsable();

/** Tells this module a recording file couldn't be opened, written or
    closed, so serviceCardCheck() re-checks the card. Only sets a flag:
    safe from anywhere, the WebSocket callback included. */
void noteCardError();

/** From loop(): after a noteCardError(), once board_idle (nothing being
    recorded, played or saved), checks whether the card still answers. If it
    doesn't (pulled out, or failed), the card is marked unusable for good -
    as if the board had booted without one: recordings stop, LIST / GET /
    DELETE answer "no SD card" - and the SD startup check turns to fail. Up
    to ~1.5 s with the card gone (the SD library's own retries), so never
    from the WebSocket callback. */
void serviceCardCheck(bool board_idle);

}  // namespace esp32va_sd_card
