tomer-gilan/Technion_Voice_Assistant_Summer_2026_A2/test/log_utils.cpp

#include "log_utils.h"

namespace esp32va_log {
// DEBUG for now, to find why a reply sometimes stalls after the recording
// ends - back to LOG_LEVEL_ERROR once that's fixed.
LogLevel g_log_level = LogLevel::LOG_LEVEL_DEBUG;
}  // namespace esp32va_log
