tomer-gilan/Technion_Voice_Assistant_Summer_2026_A2/(commit log)

2026-10-04 current build
2026-10-04 Added light sensor analyze feauture - voice assistant answers what part of day it is
2026-10-05 First prototype for a serial communication Chrome Web GUI. 5 last API responses are saved on the ESP32 SD - the GUI allows to interact with those audio files
2026-10-06 Working version of serial GUI - Stores both the raw recording from mic and the AI audio responses (up to 5) + fixed the audio clipping issue - gain from x4 to x2
    [i2s_audio_utils.cpp, i2s_audio_utils.h, recording_folder_utils.cpp, recording_folder_utils.h, reply_recorder_utils.cpp, reply_recorder_utils.h, sd_file_transfer_utils.cpp, sd_file_transfer_utils.h]
2026-10-15 Control center GUI: board status, Talk button and device controls (step 28)
    The laptop app (tools/reply_audio_app.html) now shows the board's startup
    checks (Wi-Fi with signal, SD, mic, speaker, OpenAI), the live assistant
    state (Ready / Listening / Processing / Speaking / Error), a Talk button,
    volume and mute, test beep, LED switch and brightness that follow voice
    commands, and the light sensor reading and thresholds. All existing
    recording, playback and terminal features are kept.
    Firmware: new status_report_utils (@@STAGE / @@STATE / ... lines and the
    STATUS command), device_controls_utils (VOLUME, MUTE, BEEP, LED,
    LED_BRIGHTNESS), settings_store_utils (NVS persistence), a real mic chec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
2026-10-15 Voice activity detector for hands-free listening, and a replay tool
    test/vad_utils decides, 20 ms at a time, whether the mic hears speech: the
    200-3400 Hz band level against a noise floor that adapts over about 2 s,
    voicing (a pitch between 80 and 400 Hz) and the syllable dips that knocks,
    door slams and fans don't have. Recording starts once 8 of the last 12
    frames are above the threshold and at least 4 of them voiced; it ends
    after a pause of 0.6-1.5 s (default 1.0 s) or at 10 s. An utterance with
    too little voicing or no syllable rhythm is judged not speech. Five
    sensitivity levels set the margin over the floor. Pure computation, no
    Arduino.
    tools/vad_replay.cpp compiles the same file on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
2026-10-15 Mic capture task: reads the mic without pause, keeps a 500 ms pre-roll
    test/mic_capture_utils runs a FreeRTOS task on core 1 that reads the mic
    continuously and feeds every 20 ms frame to the detector. It keeps the
    last 500 ms, so a hands-free recording starts half a second before the
    speech was detected and the first word isn't cut. Every LISTEN, manual or
    hands-free, now records through it. A capture is queued in the 32 KB
    playback ring, lent to the mic while the speaker is idle, as mu-law (one
    byte per sample, about 1.36 s at 24 kHz): a slow send to OpenAI delays the
    audio instead of losing it. If the send falls further behind than that,
    the oldest audio is dropped and counted.
    test/i2s_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
2026-10-15 Step 30: hands-free listening (VAD auto-listen)
    With hands-free on (VAD on, or the app's switch; kept in NVS like the
    volume), the board waits for speech, records from 500 ms before it until
    the speaker pauses, streams it to OpenAI while recording, and is back to
    waiting 0.6 s after the reply ends. The mic doesn't listen while the board
    speaks (half-duplex), and three non-speech utterances in a row - dropped
    by the detector, or sent and transcribed as no words - pause listening for
    5 s. LISTEN, Talk and Space keep the fixed 3 s recording. PASS: 5
    hands-free turns in a row answered with no lost audio, with the startup
    checks green and the heap low point at 20 KB or more.
    New test/hands_free_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
2026-10-15 Control center: hands-free switch, voice-level meter and sliders
    tools/reply_audio_app.html: a Hands-free switch next to Talk; a "Waiting
    for speech" state and a Waiting step; a voice-level meter with marks for
    the room noise and the speech threshold; Sensitivity and Stop after
    silence sliders under it; a note on how each utterance ended (sent after
    your pause, ignored as noise, paused after several noises); and a Talk
    button that fills up to the 10 s limit while hands-free records. Also
    fixes elements marked hidden that a class's display rule kept visible.
    tools/measurements_report.py: hands-free LISTENs get a section of their
    own, with first_audio_after_speech_ms (end of speech to the rep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
2026-10-17 Control center: Statistics panel (commands, response times, LED by voice, light sensor changes)
    Claude-Session: https://claude.ai/code/session_01Jo4Zs7PeSRdMtKm2Mn9kiR
2026-10-17 Control center: richer conversation (times, answer time, tool and noise notes, Clear)
    Each bubble shows when it arrived, the assistant's first bubble shows how
    long the answer took (from @@TIMING), and what the board did in between
    appears as a small note: the LED switched by voice, the light sensor read,
    an ignored hands-free sound, a failed LISTEN. Keeps 60 items instead of 8.
    Claude-Session: https://claude.ai/code/session_014uFpYc5CQ95rGAEt6tJ3Hy
2026-10-17 Control center: livelier orb, glowing LED bulb and part-of-day icons
    The orb's ring follows the voice level while listening or waiting for speech, and shows moving sound bars while the assistant speaks. The LED control has a bulb that glows with the LED's brightness, and the light sensor shows a sun, sunset or moon icon for its part of the day.
    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
2026-10-17 Control center: demo checklist drawer (user stories and edge cases, in Hebrew)
    A Demo checklist button opens a side drawer with the user stories and edge cases in the demo's order, each with what to say or do. Ticking an item crosses it out and fills the progress bar; ticks are kept in the browser.
    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
2026-10-17 Firmware: set_volume voice tool (a percent, or louder / quieter)
    A third tool for the model: set_volume with {percent} for a specific level ("set the volume to 30 percent") or {step: up|down} for louder / quieter by 20%. It unmutes, saves the volume like the VOLUME command, prints @@VOLUME, and lets the model confirm out loud. Not flashed yet - checked only with a host syntax check against ArduinoJson 7.4.3; see PROGRESS.md for the on-board test.
    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
2026-10-17 Control center: red banner when the USB link drops or the board halts
    Losing the serial port (not by Disconnect) shows a banner across the page saying to check the cable and that the app reconnects by itself; @@STATE halted shows why the board stopped. Reconnecting or a restart clears it.
    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
2026-10-17 Control center: Try saying card with one-click example requests
    A card under the device controls lists example requests (a question, the light, day or night, memory, volume). Clicking one starts a recording (same as Talk) and shows which phrase to say - handy when someone else tries the assistant.
    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
2026-10-17 Control center: demo checklist follows the updated user stories and edge cases
    Voice volume moves next to the other voice commands, and the two new edge cases (a request the board can't do, a volume out of range) and the USB banner are in the list.
    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
2026-10-17 Docs: visual README, voice volume in the user stories, three new edge cases, PDFs regenerated
    README: a control-center screenshot at the top, diagrams from our presentation (hardware, one sentence's path, the LED tool call, response time, boot and memory), a table of the model's tools, the statistics panel, and the library / IDE / core versions filled in. User stories: voice volume (new #5), the richer conversation view, the chart and CSV. Edge cases: the USB banner, a request the board can't do, a volume out of range. docs/*.pdf regenerated (A4 landscape, one page each).
    Claude-Session: https://claude.ai/code/session_014u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
2026-10-17 Firmware: get_current_time and set_timer voice tools
    Two more tools in a new clock_timer_utils module. get_current_time answers from the SNTP clock ("What time is it?"). set_timer {seconds} rings after 1-3600 s - LED blinks and 3 beeps once the board is idle, hands-free held off around the beeps - and seconds 0 cancels. @@TIMER lines for the app, and STATUS reprints the timer. Not flashed yet - host syntax check only; see PROGRESS.md for the on-board test.
    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
2026-10-17 Control center: timer countdown and clock in the GUI
    @@TIMER shows a countdown chip next to the state steps (blinking Ringing! when it goes off), the conversation notes when a timer is set, cancelled or done and when the clock was read, the chart marks those commands, and the Try saying card and demo checklist include the timer and the time.
    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
2026-10-17 Docs: timer and clock in the README and user stories, CLAUDE.md modules, PROGRESS.md
    README lists the timer and clock and their two tools; user story #6 demos them; CLAUDE.md lists clock_timer_utils and the set_volume tool; PROGRESS.md (Hebrew) tracks the night's commits, what to test on the board, and how to review, push or merge.
    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
2026-10-17 GUI: Stage view, a big view of the assistant for the room
    A fullscreen overlay (button or F key) with a large orb, the state, the last question and answer, and the LED, part of day, volume and timer. Esc closes; Space still talks.
    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
2026-10-17 GUI: replay a saved log
    Replay a log… in the serial terminal plays a log the app saved back through the status-line handler, with its own timing (1x, 4x, 20x or all at once; long pauses shortened to 3 s). Works only while no board is connected; connecting stops it. Useful as a demo backup and to rebuild the statistics from an old run.
    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
2026-10-17 Docs: architecture.md (modules, states, @@ protocol)
    A new document explaining the code: a block diagram, a table of the modules, what loop() does, a state diagram, the @@ status lines and serial commands, how a tool is added, and the memory budget. README links it and lists Stage view and log replay; PROGRESS.md updated.
    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
2026-10-17 GUI: full-screen session summary for the end of the demo
    A Summary button in Statistics opens a big screen: commands, share answered, median response time, startup time, what the assistant did (per tool), and the board's settings now. Updates live while open; Esc closes. Added to the demo checklist.
    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
2026-10-17 GUI: guided tour for first-time users
    A Tour button walks through the page in 9 stops (connect, startup checks, Talk, Hands-free, conversation, phrases, settings, statistics, Stage view), with a spotlight on each part and a card that explains it. Arrow keys move, Esc ends it. Meant for the examiners operating the project themselves.
    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
2026-10-17 Voice reminders: set_timer takes a label and the board says it when done
    set_timer gets an optional label ("Remind me in 30 seconds to check the oven"). When the timer rings, after the beeps the assistant says "Time's up - check the oven." (or "your timer is done" without a label) through a response.create nobody waits on, like the opening greeting; @@STATE speaking timer while it talks. The label is cut to 48 safe characters so it can go into JSON as is. @@TIMER lines carry the label; the control center shows it in the countdown chip and the conversation, and Try saying has a reminder example.
    Claude-Session: https://clau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
2026-10-17 Docs: voice reminders in the README, user story 6, architecture and demo plan
    Tools table and features list mention reminders; user story 6 demonstrates one (PDF regenerated, one page); architecture.md shows the label on @@TIMER and the speaking timer detail; the demo plan sets a 60-second reminder; CLAUDE.md and PROGRESS.md (board tests, revert order) updated.
    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
2026-10-17 "What can you do?" gets a one-sentence answer listing the board's skills
    One more sentence in the session instructions, so asking what it can do lists answering questions, the light, volume, timers and reminders, and the time or part of the day - a natural opener for the demo. The control center's Try saying card starts with that question.
    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
2026-10-17 Docs: one-page quick start for examiners (md + PDF)
    docs/quick-start.md and an A4 PDF: how to start (connect, wait for green, Talk or Hands-free, Tour), a table of things to try with what happens, what the screen shows, and what to do if something fails. Linked from the README and the demo plan (print one copy for next to the laptop).
    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
2026-10-17 Docs: new control-center screenshot, Stage view and Summary images in the README
    The README screenshot now shows the Tour button, the reminder countdown and the new phrases; Stage view and Summary get a picture each, and the GUI list mentions Summary and Tour. Quick start PDF re-rendered with the new screenshot.
    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
2026-10-17 "How long is left on my timer?": get_current_time also reports a running timer
    While a timer runs, get_current_time's result ends with "The timer has N seconds left - <label>.", and the instructions send timer questions to it - no new tool needed. The tool-output buffer grows from 256 to 384 bytes to fit the longer text.
    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
2026-10-17 PROGRESS.md: latest commits and board tests
    Adds the quick start, screenshots and timer-left commits, a board test for asking how long is left, and the revert order.
    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
2026-10-17 Docs: colored wiring diagram with every pin
    docs/images/wiring.png: the ESP32 with each module's pins, the I2S clock lines the mic and amp share, the SD card's SPI lines, power and ground, the onboard LED, and the planned LDR on an ADC1 pin. Replaces the ASCII drawing in the README (kept below it, folded).
    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
2026-10-17 Timer rings even while OpenAI is unreachable
    The timer used to wait for boardCanListen(), which needs the OpenAI session - so a dropped connection held the alarm back. It now rings once nothing is being recorded, played or saved, and is only announced out loud when the session is up.
    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
2026-10-17 Docs: edge case 19 (timer with no internet), PROGRESS.md
    The timer runs on the board, so it beeps and blinks even with the hotspot off; only the spoken announcement needs OpenAI. Edge-cases PDF regenerated (still one page). PROGRESS.md lists the wiring diagram and the new commit, with a board test and the revert order.
    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
2026-10-17 Dim the LED by voice: set_board_state takes an optional brightness
    "Dim the light to 30 percent" now works: set_board_state gets an optional brightness_percent (0-100), saved like the app's slider (esp32va_controls::setAndSaveLedBrightness). The instructions tell the model the LED has one color and can't blink. The control center notes the brightness in the conversation; Try saying and the demo checklist use the new phrase, and the 'can't do' example becomes "Make the light blue".
    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
2026-10-17 Docs: dimming by voice in the stories, README, quick start; edge case 16 is now 'Make the light blue'
    User story 4 dims the light, the README tools table and features list mention it, the quick start and architecture follow, and since a brightness now works, the impossible request in edge case 16 and the demo plan is a color change. PDFs regenerated (each one page). PROGRESS.md: board test and revert order.
    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
2026-10-17 GUI: save the conversation as text; edge case 19 in the demo checklist
    A Save button next to Clear downloads the conversation as a .txt (time, who, what was said, the answer time, and the notes about what the board did). The demo checklist gets the timer-without-internet edge case.
    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
2026-10-17 GUI: demo checklist ticks items by itself when the board shows them
    A live board ticks boot, Talk, hands-free, LED, voice volume, day/night, timer (and timer without internet), transcript, ignored noise, noise pause, USB reconnect and Summary, with a short toast. The checklist button shows the count. Not during a replayed log.
    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
2026-10-17 Ask by typing: ASK <text> for a noisy room
    Firmware: the ASK serial command sends a typed question into the same conversation as a text message and the reply is spoken like the greeting (busy and not-connected are refused, 200 chars max, echoed as @@HEARD, speaking detail 'typed'). No LISTEN, so no recording or @@TIMING. GUI: an 'Or type a question' box under Talk, a 'typed' tag on the bubble, a note when the board refuses or has older firmware, a Tour sentence and a demo checklist item.
    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
2026-10-17 Docs: typed questions (edge case 20), auto-ticking checklist, demo GIF in PROGRESS
    Edge case 20 (a room too noisy to talk: type the question), ASK in the architecture command table and the speaking 'typed' detail, README bullet, a line in the quick start and the demo plan's failure table, a note in CLAUDE.md on why ASK lives in test.ino. PDFs regenerated (still one page each). PROGRESS lists d9de9bf, 20de4c7, 4f6ecce and a board test for ASK.
    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
2026-10-17 'How are you doing?': get_board_status tool reports Wi-Fi, uptime and memory
    New module board_info_utils: the read-only get_board_status tool answers with the Wi-Fi signal (strong/good/fair/weak and dBm), minutes since power-on and free heap. Session instructions and the 'what can you do' sentence mention it (session message now ~4.9KB). GUI: tool label, a conversation note, chart and Summary entries, and a Try saying phrase.
    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
2026-10-17 Docs: get_board_status in the README, architecture, CLAUDE.md and PROGRESS
    Tool table row and a feature bullet, the new module in the architecture and CLAUDE.md module lists, and a board test for 'How are you doing?'.
    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
2026-10-17 GUI: Self-test button checks the board before a demo
    In Board health: startup checks, Wi-Fi signal, LED blink (put back as it was), BEEP, LIGHT, SD listing and the OpenAI session, one after another with a result each. Uses existing serial commands only.
    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
2026-10-17 Docs: Self-test in the README, demo plan and quick start; new control-center screenshot
    The screenshot now shows the typed-question box, the Self-test button and the new Try saying phrase. Quick start PDF regenerated (one page). PROGRESS lists 253fe9f and 97ca2ae.
    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
2026-10-17 Real LDR support, off until LIGHT_SENSOR_PIN is defined
    With #define LIGHT_SENSOR_PIN <ADC1 pin> in config.h the board reads the LDR once a second (mean of 8 samples, * 1.5 to the 0-6142 scale), prints @@LIGHT when the part of the day changes or the value moves by more than 150, and refuses LIGHT <value>. Without the define nothing changes (serviceLightSensor() is empty). config.h itself is not touched.
    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
2026-10-17 Docs: how to connect the real LDR
    README hardware row and limitations (divider wiring, the LIGHT_SENSOR_PIN line for config.h), architecture and CLAUDE.md module notes, PROGRESS board test 11 and revert hint.
    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
2026-10-17 Timer announcement buffer: room for the longest label
    GCC (-Wall, esp32 core 2.0.17) warned the announcement JSON could be cut with a long label, which would break it. kAnnouncementBufferSize is now kMaxLabelLength + 200. Found by a full compile of the sketch with arduino-cli: it builds, 1,062,821 bytes (81% of flash).
    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
2026-10-17 PROGRESS: the sketch compiles (arduino-cli, core 2.0.17)
    Flash and static RAM before and after the night's changes, and the timer buffer fix in the firmware table.
    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
2026-10-17 GUI: Save report - the session as one HTML page
    A button in the Summary overlay saves a self-contained HTML file: the summary tiles and chips, the response-time chart, a table of every command (mode, tool, result, the three timings) and the conversation. Uses the page's own styles.
    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
2026-10-17 README: firmware size and an arduino-cli build line
    Flash (1.06MB, 81%) and static RAM (75KB) of the current build in the memory table, and the arduino-cli compile command in the run steps.
    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
2026-10-17 GUI: demo clock with the current demo-plan step
    A button in the Demo checklist drawer starts a header chip that counts up and shows which part of the 25-minute demo plan you should be in. It turns red after 25 minutes; click it to stop.
    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
2026-10-17 Docs: QR code to the GitHub repo on the quick-start page
    Examiners holding the printed page can scan it to open the README. The screenshot is a bit smaller so the PDF stays one page.
    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
2026-10-17 Docs: TIMEZONE_POSIX in README, CLAUDE.md and board test 5
    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
2026-10-17 Board clock check: @@CLOCK line, CLOCK command and a Self-test row
    The board prints @@CLOCK <HH:MM> <unix time> in the STATUS reply and for the new CLOCK command. The control center's Self-test compares it with the laptop clock and warns when the board is an hour off (a time zone or summer time problem), pointing at TIMEZONE_POSIX. Older firmware: the row says to ask What time is it? instead.
    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
2026-10-17 Docs: @@CLOCK and CLOCK in architecture, README and the board tests
    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
2026-10-17 Voice: switch the light later - Turn off the light in 20 seconds
    set_timer gets an optional light (on/off): when the timer rings, the board beeps and then leaves the LED in that state (@@LED ... voice), labelled light off/on unless the user gave a label. The instructions tell the model to call only set_timer for these requests. Control center: a Try saying phrase, a clearer conversation note and the checklist text.
    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
2026-10-18 Docs: the light timer in README, user story 6, CLAUDE.md and board test 6
    User stories PDF regenerated (still one page).
    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
2026-10-18 Docs: printable demo-plan.pdf, summer time in the demo plan, file-transfer error lines
    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
2026-10-18 Firmware: fixes from a code review of the new tools
    - set_timer / set_volume with unusable arguments now still answer the call with an error text, so the model speaks instead of going quiet.
    - Clamp the float before lroundf (a huge number could have turned into a negative timer, which cancels it).
    - ASK no longer cuts a multi-byte (Hebrew) character in half at 200 bytes.
    - static_assert that LIGHT_SENSOR_PIN is an ADC1 pin (ADC2 can't be read with Wi-Fi on).
    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
2026-10-18 PROGRESS: review fixes and the current compile size
    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
2026-10-18 GUI: fixes from a code review
    - @@CLOCK is a status tag, so the Self-test's Board clock row gets its answer (it always timed out).
    - Connect board loses focus after the click, so the next Space talks instead of disconnecting.
    - The typed-question box goes read-only (not disabled) while the board is busy, so it keeps focus mid-typing.
    - Replugging the board retries opening the port a few times (Windows is often not ready at once).
    - A typed question that was never echoed back stops counting after 20 s.
    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
2026-10-18 Docs: consistency pass against the code
    Edge cases 2, 6, 10, 19 and 20 now describe what the GUI and firmware really do (Busy/disabled buttons, no-words noise, giving up after 5 reconnects, no late timer announcement). User stories: Connect board, the full list of conversation tags. README: every timer is announced. PDFs regenerated, still one page each.
    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
2026-10-18 README: try the control center without a board (Replay a log)
    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
2026-10-18 Docs: fresh control-center screenshot (with the light-timer phrase)
    Also in the quick-start PDF, still one page.
    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
2026-10-18 PROGRESS: board tests and changed-docs list brought up to date
    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
2026-10-18 PROGRESS: the timer module was also run on a laptop with stubs
    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
2026-10-18 README: known limits - LDR direction and ADC1 pins, timer without internet
    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
2026-10-18 Firmware: skip the full JSON parse for session.created/updated
    The server echoes the whole session (6 tools + instructions, ~6KB) in these events. Parsing them into a JsonDocument could run out of heap and leave the OpenAI stage stuck. Nothing in them is read, so the type from extractEventType() is enough.
    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
2026-10-18 Firmware: diagnostic logging for the stall after recording
    Temporary: log level DEBUG by default, a millis() timestamp on every LOG line, and free heap / largest block when the audio is committed, on a JSON parse error and on a reply timeout. Revert the log level to ERROR once the stall is found.
    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
2026-10-19 Firmware: log level back to ERROR
    The DEBUG default from 916d9b5 was only for diagnosing the hands-free stall (fixed in 5e4074a). The diagnostic lines stay, visible at DEBUG.
    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
2026-10-19 PROGRESS: board-test fixes (session.updated, hands-free stall, diagnostics)
    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
2026-10-20 Fix double tool-call error, start voice timers after their confirmation, add CANCEL
    - Two tool calls in one response no longer send two response.create
    (the second hit "Conversation already has an active response"):
    the follow-up response.create is sent once, on the tool response's
    response.done.
    - A timer set by voice starts counting once the board has finished
    saying it's set, not when it was asked for.
    - New CANCEL command and Cancel button in the app: drops the LISTEN
    being recorded (input_audio_buffer.clear) or waiting for its answer
    (response.cancel, its audio and tool calls skipped).
    Claude-Session: http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
2026-10-20 VAD: only voiced frames keep a hands-free utterance open
    With moderate background noise, noise frames kept counting as active
    once speech had lowered the margin, so the recording ran until the
    noise stopped (or the 10 s cap) and was then often discarded as too
    steady/unvoiced - no answer. The hangover now restarts on voiced
    frames only, so trailing noise no longer extends the utterance or
    dilutes its judgement.
    Claude-Session: https://claude.ai/code/session_01Rmqkn4JkqnmBJcPymCZun8
2026-10-22 Restructure the repo to the course template
    - test/ -> ESP32/ (the firmware sketch, ESP32.ino), docs/ -> Documentation/,
    the control center -> control_center/control_center.html
    - Hardware tests 02-05 -> Unit Tests/, every other step sketch ->
    Documentation/development_steps/
    - config.h split into SECRETS.h (git-ignored; SECRETS.example.h is the
    template) and parameters.h (every hard-coded parameter, with the
    tunables that were spread over the modules). Same values - no change
    in behavior.
    - CLAUDE.md and PROGRESS.md kept locally only
2026-10-22 Robustness: no SD card, offline mode, Wi-Fi without a compile
    None of these change a normal run (card in, Wi-Fi and OpenAI up):
    - No usable SD card no longer halts the board: it runs on without
    recordings (red SD lamp; LIST/GET/DELETE answer with an error line).
    - The OpenAI connection is never given up: after 5 failed attempts in a
    row the board reports itself offline (@@STATE offline) and keeps
    retrying every 30 s. The timer and the controls keep working.
    - Fix: the attempt count was only reset on the first connection, so 5
    disconnects spread over a long session (each one reconnected fine)
    halted the board. It now resets on every successful reconnect.
    - setup() no longer waits fo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
2026-10-22 I2S: no master clock pin (it was put out on GPIO0)
    i2s_pin_config_t's mck_io_num was left out of the initializer, so it was
    0 - and the ESP32 driver routes MCLK to GPIO0 (one of the three pins it
    allows for it), the BOOT button's pin. Neither the INMP441 nor the
    MAX98357A uses MCLK, so it is now I2S_PIN_NO_CHANGE. Likely the source of
    the unexplained readings on the BOOT button in steps 19/20 (not measured).
    Also fills the two missing i2s_config fields with their defaults (same
    values as before) - the build has no -Wmissing-field-initializers
    warnings left.
    Revert this commit alone if the audio behaves differently on the board.
2026-10-22 Talk button and status sounds (both off by default), small tool fixes
    - BUTTON on|off: the BOOT button as a physical Talk button - a press
    starts a LISTEN, a press while recording or answering cancels it.
    Debounced with a saturating counter. Off until switched on (kept in
    flash), so an untested board behaves as before. (@@BUTTON)
    - SOUNDS on|off: short tones for what the board can't show without the
    laptop - going offline, back online, a failed question. Played only
    when the board is quiet, with hands-free held off around them like
    BEEP, silent while muted. Off by default. (@@SOUNDS)
    - set_board_state with unreadable arguments now answers the model with an
    error (like the other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
2026-10-22 Code organization: every module in its namespace, a firmware header
    - i2s_audio_utils -> esp32va_audio, realtime_json_utils -> esp32va_json,
    board_state_utils' remaining free functions -> esp32va_board, and
    ESP32.ino's functions in its anonymous namespace (only setup() and
    loop() stay global). Call sites qualified; no change in behavior (same
    binary size before the ESP32.ino part, which only lets the compiler
    inline a little more).
    - ESP32.ino's header describes the firmware rather than only step 30.
    - Comments point to Documentation/decisions.md instead of local-only
    notes (PROJECT_OVERVIEW.md / CLAUDE.md).
2026-10-22 Control center: Wi-Fi card, offline state, BOOT button and sounds switches
    - Wi-Fi network card: shows the network in use (@@WIFI_NET) and saves a
    new one on the board (WIFI_SSID + WIFI_PASSWORD); the password is
    masked in the terminal log. 'Back to default' sends WIFI_FORGET.
    - The board's @@STATE offline is shown as a red 'Offline' (no Wi-Fi / no
    OpenAI, still retrying) - kept apart from the app's own 'Not connected'.
    - 'On the board itself' switches: the BOOT Talk button (BUTTON) and the
    status sounds (SOUNDS).
    - All three appear only once the board reports them, so older firmware
    looks as before. Also: DELETE_ALL_ERROR now ends a pending Delete all
    instead of letting it time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
2026-10-22 Unit Tests: standalone hardware tests and their report
    - 02-05 (speaker, mic, loopback, Wi-Fi) no longer need config.h - each
    carries its own pins, so it opens and uploads on its own.
    - New: 06 SD card (mount, write, read back, compare, delete), 07 LED PWM
    (fades, 100/30/0%), 08 BOOT button (the firmware's debounce, raw noise
    count, and a switch that reproduces the old I2S setup to test the MCLK
    explanation), 09 LDR (range and direction).
    - Unit Tests/README.md: what each test checks, how to tell it passed, and
    the result (02-05 passed in steps 2-5; 06-09 still to be run).
    All eight compile with arduino-cli; 06-09 without warnings.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
2026-10-22 Documentation for submission: README, decisions, states, calibration
    - README follows the course template: team, folder description, SDK and
    library versions, hardware with quantities, wiring, install, poster
    placeholder, who-did-what (to be completed by the team).
    - New: decisions.md (significant decisions, what each rests on - the
    places code comments pointed at), system-states-and-errors.md,
    calibration.md, Parameters/parameters.md, user-test.md (template - not
    run yet), board-tests-toSubmit.md (what to check on the board before
    merging this branch).
    - edge-cases.md rebuilt in the course's format (user indication +
    recovery) with the new cases; demo-plan's edge-case numbers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
2026-10-22 Fixes from a review of the robustness changes
    - Going offline now slows the OpenAI retries to every 30 s itself: a
    failed connect raises no disconnect event, so the backoff could stay at
    ~1 s and keep holding loop() up with connect attempts.
    - When Wi-Fi drops (or the network is switched), the OpenAI socket is
    closed at once instead of waiting for a send to fail - the state shows
    reconnecting/offline right away and the next LISTEN doesn't time out.
    - Wi-Fi is started over only 60 s after the last attempt (was 20 s, which
    could cut off an attempt about to succeed and duplicated the core's own
    retries).
    - Offline before any connection was started says why ('no clock') rather
    than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
2026-10-22 Edge cases: keep the original tested list, mine becomes edge-cases-extended
    - Documentation/edge-cases.md and edge-cases-v3.pdf are back exactly as
    they were on the improvements branch (the list the team tested).
    - The course-format list with the submission's new cases is now
    edge-cases-extended.md / .pdf; the demo plan's edge-case numbers refer
    to it, and README links both.
2026-10-22 Unit Tests: no I2S master clock pin in tests 02-04
    They left mck_io_num unset (0), so the driver put MCLK out on GPIO0, the BOOT button's pin. The firmware fixed this in 94dd280; set it to I2S_PIN_NO_CHANGE here too.
2026-10-22 Unit Tests: clear verdict lines for tests 02, 03, 04
    02 checks the driver and that every sample was accepted, then asks for the by-ear verdict (SPEAKER TEST DONE - PASS if ...). 03 prints MIC TEST PASSED when the RMS clearly rises above the quietest window within 15 s, else FAILED with the reason. 04 prints LOOPBACK TEST FAILED if the recording is silent, else the by-ear DONE line.
2026-10-22 Unit Tests: Wi-Fi test gets a 20 s timeout and a verdict
    A wrong SSID or password used to wait forever. Now it prints WIFI TEST FAILED after 20 s, WIFI TEST PASSED on connect, and keeps the reconnect-after-drop behavior once connected.
2026-10-22 Unit Tests: LED test uses the firmware's square brightness curve
    board_state_utils.cpp computes duty = percent^2 * max / 100^2; the test used a linear curve, so its 30% looked brighter than the firmware's. Same curve now.
2026-10-22 Unit Tests: LDR test verifies covered reads lower than lit
    Two guided phases (cover, then flashlight); each phase is averaged, and the verdict checks lit minus covered >= 1500, with a specific FAILED message when covering reads higher (swap the LDR and the resistor). Header now says the LDR is not wired on the submitted board (value simulated by the firmware) and the test is kept ready for when it is.
2026-10-22 Unit Tests: README - passed statuses, new verdict lines, LDR not wired
    Submission firmware and tests 06, 07, 08 are marked passed on the board. 02-05 list their new verdict lines. 09 is described as not wired (value simulated per the instructor), test kept ready. The MCLK sections now say tests 02-04 were fixed to match the firmware, and that 02-05 and 09 changed since their last board run.
2026-10-22 Docs: board-tests-toSubmit becomes a results report
    All checklist items ran on the board with the submission firmware and
    passed, so the file gets a result column, a new intro, and no pre-merge
    instructions. decisions.md no longer says the BOOT button, status sounds
    and MCLK fix were untested on the board. Finding DOC-05.
2026-10-22 Docs: VAD evaluation with rates and test conditions
    Rates next to the counts (100/100, 7/27, 20/112), and a "how we tested"
    list: tool, build/run command, sensitivity and hangover, clip groups,
    sample-rate handling, the on-board hands-free check, and the step-29
    caveat for the latency and heap numbers. Finding DOC-04.
2026-10-22 Docs: one wording for the unwired LDR
    The LDR stays in the hardware list, but every doc now says the same
    thing: not wired, value simulated from the control center per the
    course instructor's guidance, and the calibration section is for when
    it is wired. Finding DOC-06.
2026-10-22 Docs: README edge-case links and the print note
    The original list's PDF now links to edge-cases.pdf (edge-cases-v3.pdf is
    retired), user-stories gets its PDF link, and the extended list is marked
    as the one to print (2 copies). Finding DOC-07 (README part).
2026-10-22 Docs: stop presenting the empty user-test template as a result
    Documentation/user-test.md is a blank template ("not performed yet", empty
    result tables), so the README row that described it as a test with outside
    users and the fixes it led to is removed. The file itself is untouched.
    Finding DOC-10.
2026-10-22 Docs: hardware table wire count and pin table details
    Wires become "a set, about 20" with the count taken from the wiring
    diagram (mic 6, amp 5, speaker 2, SD module 6), USB cable and power bank
    get their own rows, and the pin table gains the mic L/R-to-GND, the amp
    SD/GAIN pins and the speaker rows. Finding DOC-13 (text part).
2026-10-22 Docs: list the PC tool dependencies and the Boards Manager step
    Python 3.6+ (tested 3.11.2), websocket-client (tested 1.8.0), a C++11
    compiler for vad_replay, and PowerShell 5.1 for serial_logger, plus an
    explicit "esp32 by Espressif Systems 2.0.17" first step in the install
    instructions. Finding DOC-15.
2026-10-22 Docs: README measurement conditions and a demo-length timer example
    RSSI wording now matches the committed log (boot -37..-45 dBm, during the
    26 questions median -48, range -38..-62; re-computed from the log). The
    set_timer example becomes "30 seconds" and the table notes the demo uses
    20-60 s timers. Findings DOC-17, DOC-19.
2026-10-22 Docs: neutral placeholders for the hotspot name and LAN IP
    The hotspot SSID and the board's LAN address are replaced by <hotspot>
    and <board-ip> in architecture.md and in the tracked measurement log;
    nothing else in the log changes. Finding GIT-06.
2026-10-22 Docs: drop the toSubmit branch name from the docs
    The final code lives on main, so the docs no longer present the
    "toSubmit branch" as where the submission version is. The old config.h
    reference in the board-tests file went with its rewrite; the remaining
    step numbers, Gemini and config.h mentions are historical and already
    framed as such. Finding DOC-16 (my files).
2026-10-22 Docs: describe the new connection and Talk behavior
    system-states-and-errors.md and architecture.md now say: the OpenAI health
    light turns red whenever the board is offline (also Wi-Fi up, no
    internet); OpenAI reconnects within seconds when Wi-Fi returns; Talk and
    LISTEN are refused while the assistant is still answering; the typed
    question limit is 200 bytes; a heartbeat and the reply timeout close a
    dead connection; a saved Wi-Fi that keeps failing falls back to the
    SECRETS.h network (one separate line each, easy to drop if that change
    does not land). The clock is described as Israel time with summer time.
    Parallel firmware findings FW-02..FW-05, FW-07, FW-11, DEMO-09.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
2026-10-22 Docs: README doc table lists the board-test results report
    Keeps the README consistent with the other edits: the results report
    gets its row, next to the removed user-test row and the edge-case rows.
2026-10-22 Docs: edge-cases.md - the board does not stop after 5 failed OpenAI connections
    Row 5 said it stops with a red OpenAI light. It goes Offline (red light),
    keeps retrying every 30 s and recovers by itself. Row 7 now says that
    unplugging USB restarts a board that has no power bank. (FW-13, DOC-07)
2026-10-22 Docs: edge-cases-extended.md - clean wording, every case actionable in the room
    Removed the future-tense "will be tested on the board" line and the
    board-tests link, each "how to demo" now says what the presenter does
    (second phone for the network switch, mobile data off for OpenAI down,
    power bank before unplugging USB), the light-sensor case uses the slider,
    the typed Ask limit is 200 bytes, case 8/17 fixed, case 24 added
    (speech at 1 m with background noise). Numbers 1-23 unchanged. (DEMO-06)
2026-10-22 Docs: user stories + demo slots for features that had none
    New stories: "How are you doing?" (get_board_status), typed Ask, Cancel,
    Self-test, log Replay, Hebrew conversation. Each verified against ESP32/
    and control_center.html first. Demo plan gets matching slots. (DEMO-05)
2026-10-22 Docs: user stories ordered basic -> advanced -> settings/statistics; plan follows
    The Wi-Fi network story is now a setup precondition (switching is edge case
    3), no-PC and log Replay come after the settings/persistence stories and
    statistics are last, as the course requires. The demo plan runs the same
    numbers in the same order, and the edge cases ride along with their story
    or sit in one robustness block before the statistics. (DEMO-04, DOC-12)
2026-10-22 Docs: hotspot setup in quick-start and the demo plan's day-before steps
    2.4 GHz (iPhone: Maximize Compatibility), SSID/password limits, set once in
    SECRETS.h or from the Wi-Fi network card (no recompile), a full test run
    beforehand, no Technion Wi-Fi, and a second phone's hotspot for the
    network-switch story / edge case 3. (DEMO-02)
2026-10-22 Docs: demo-plan logistics from the course guidelines
    Arrive 20 minutes early (was 10), phone at the window, backup video on the
    laptop, project video within a week, equipment returned on demo day in a
    bag with the group number and name, two printed copies each of
    user-stories.pdf and edge-cases-extended.pdf. States that the log Replay is
    not a substitute for the backup video. (DEMO-03, DOC-11, DEMO-08)
2026-10-22 Docs: budget about 15 s for recovery after the hotspot returns
    The firmware now reconnects as soon as Wi-Fi is back, so recovery takes a
    few seconds. The plan's robustness block and the Wi-Fi contingency row
    budget ~15 s, and edge case 1 tells the presenter to wait up to ~15 s.
    (DEMO-07)
2026-10-22 Docs: one set of timer examples across the demo documents
    30 s for the reminder and timer examples, 20 s for "turn off the light
    in", all under a minute. Stories, quick-start, edge cases and the plan
    already agree; the plan now says so, so the TA sees the same numbers as the
    printed pages. (DEMO-10)
2026-10-22 Docs: demo contingencies for a noisy room and for OpenAI quota/key failure
    Noisy room: lower Sensitivity first, then Talk mode, typed Ask as the last
    resort; set Sensitivity beforehand and ask for 20 s of quiet for story 5.
    OpenAI red with Wi-Fi up: check the balance the day before, keep a spare
    key with credit ready, show the Offline edge case meanwhile and switch to
    the backup video. (DEMO-11, DEMO-12)
2026-10-22 Docs: no-PC story - power bank first, then unplug USB
    Unplugging USB alone reboots the board (about 10 s to the greeting), so the
    story, the plan row, the day-before checklist and edge cases 9/11 say to
    connect the board to the power bank before unplugging the USB cable from
    the laptop. (DEMO-13)
2026-10-22 Docs: describe the firmware fixes - Talk refused while speaking, Cancel as the way out
    Edge case 3 (original list), the Cancel story and the quick-start table say
    Talk is refused while the assistant is still speaking: wait for it to
    finish or press Cancel. The red OpenAI light when offline was already
    described in edge cases 4/5 and the contingency table.
2026-10-22 Docs: demo plan - clock follows the Israel time zone automatically
    Dropped the day-before recompile step for summer time and the "if the
    button and sounds were tested" caveat (everything passed on the board). The
    wrong-time contingency now points at the time server and the Self-test
    clock row. (DEMO-09, DEMO-01)
2026-10-22 Docs: questions.md - answers brought in line with the final behavior
    Offline recovery (~15 s, red OpenAI light), power bank before unplugging
    USB, Talk refused while speaking, the BOOT unit test passed on the board,
    and a new answer on why the light sensor is simulated (slider, per the
    course instructor).
2026-10-22 Docs: demo plan timeline - 20 min setup, then 25 min with intro first and statistics last
    States the printed set (user-stories.pdf and edge-cases-extended.pdf, two
    copies each), the 1-minute no-slides intro, basics first, settings and
    statistics last, which edge cases are left out of the table and why, and
    the places where the TAs operate the device themselves. (task 13)
2026-10-22 Control center: keep a replayed log out of the live log and statistics
    Audit CC-01. Replayed lines are shown in the terminal but no longer go
    into the saved log file or the Download log buffer, where they passed
    for new live @@TIMING lines. While a replay runs, Statistics, the chart,
    Summary and CSV use a separate set of counters; the live ones come back
    when the replay ends or a board connects. The Statistics hint now says
    the counters run since the page was opened.
2026-10-22 Control center: drop the 921600 baud option
    Audit CC-02. The firmware's Serial is fixed at 115200 (kSerialBaudRate in
    ESP32/parameters.h), so picking 921600 opened the port but garbled every
    byte, and the page looked dead with nothing pointing at the baud setting.
    The select keeps its single 115200 option, so the code that reads it is
    unchanged.
2026-10-22 Control center: replay logs made by serial_logger.ps1
    Audit CC-03. serial_logger.ps1's logs end each line in \r\r\n and start
    with a BOM, so the timestamp pattern failed on every line and Replay
    rejected the file as having no status lines. The replay parser now drops
    a leading BOM and splits on /\r*\n/; the live line splitter strips any
    run of trailing CRs the same way.
2026-10-22 Control center: show Board health while replaying a log
    Audit CC-04. renderHealth drew the stages only while a board was
    connected, so a replayed run's startup checks never appeared. It now
    also draws them while a replay is running.
2026-10-22 Control center: byte limits for ASK and Wi-Fi; Saved only once the board says so
    Audit CC-05. The firmware counts bytes, not characters: ASK keeps 200
    bytes (kMaxTypedQuestionLength), an SSID 32 and a password 8-64
    (wifi_utils.cpp). The page now checks UTF-8 bytes, so a long Hebrew
    question is refused with a note instead of being cut mid-question, and a
    Hebrew SSID that is too long is caught before sending. A password with
    spaces at either end is refused, since the board trims them.
    Save & connect now says "Saved" only when the board answers
    @@WIFI_NET saved <ssid>; a "WIFI_SSID ignored" / "WIFI_PASSWORD ignored"
    line is shown as the reason, and no answer within 4 s says so. Both lines
    alre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
2026-10-22 Control center: Hebrew transcripts read right to left
    Audit CC-06. A bubble's text now sits in its own span with dir="auto"
    and text-align: start, so a Hebrew @@HEARD/@@SAID line takes its own
    direction (the "?" lands at its end, aligned right) instead of the
    page's LTR, in the main view, Stage view and saved report. Save
    conversation reads the text from that span.
2026-10-22 Control center: a board restart mid-download no longer freezes the page
    Audit CC-07. During a GET the link swallowed exactly <size> bytes as
    audio, so if the board restarted mid-transfer its boot output and every
    status line after it were eaten for up to ~90 s.
    - The binary stream is watched for what a restart prints first (the ROM's
    "rst:0x" and the firmware's "@@STATE booting"); seen, the GET fails at
    once and the boot output is read as lines again from there.
    - A watchdog fails the GET when no bytes arrive for 2 s.
    - The overall budget is the wire time plus a quarter and 2 s (was double
    plus 5 s).
    - After a stall or timeout, bytes up to the next newline are skipped, so
    leftover au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
2026-10-22 Control center: CSV gets a date and command numbers unique across restarts
    Audit CC-08. The board's command number n starts at 1 again after every
    restart, and the CSV had only a time of day.
    - Statistics count board sessions: a new one starts at @@STATE booting
    after a command, or when n goes back (a restart while unplugged).
    - CSV columns are now index, date, time, board_session, board_command,
    mode, tool, result and the three timings (was command, time, ...).
    - The chart, its tooltip and the saved report label a command "#2.7"
    (2nd board start, 7th command) once the board has restarted.
    - The CSV is UTF-8 with a BOM and CRLF rows, with fields quoted when
    needed, so Excel reads any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
2026-10-22 Control center: log unhandled status lines and hands-free events
    Audit CC-09 (Code Convention #3). The status dispatcher's default now
    logs the unknown tag instead of dropping it silently; @@CLOCK, read only
    by the self-test's waiters, has its own case. onVadEvent logs an event
    kind it doesn't know.
2026-10-22 Tools: serial_logger writes clean LF lines, UTF-8 without a BOM
    Audit TL-04. With NewLine = LF, ReadLine() kept println's CR, and
    Add-Content added CRLF, so every board line ended in CR CR LF; under
    PowerShell 5.1 Add-Content -Encoding utf8 also started the file with a
    BOM. Lines are now trimmed of the CR and appended with one LF through
    UTF8Encoding($false). The log path is resolved against PowerShell's
    location first, since .NET would use the process directory.
2026-10-22 Tools: realtime_audio_diagnostic no longer claims to match today's session
    Audit TL-05. The script said it mirrors ESP32.ino's kSessionUpdateMessage
    "exactly", but it sends the step-13 (2026-09) session: 24 kHz PCM output,
    no transcription, no tools, short instructions. The firmware now uses
    8 kHz mu-law output, input transcription, six tools and long
    instructions. The docstring and comment now say it reproduces the
    step-13 flow on purpose and list how today's session differs; the
    session itself is unchanged, since the script exists to reproduce that
    run.
2026-10-22 Tools: vad_replay low-passes before downsampling; header lists what it doesn't model
    Audit TL-02.
    - A .wav above 24 kHz (44.1/48 kHz) is now filtered with a 127-tap
    Blackman windowed-sinc low-pass (cutoff 11 kHz) before the resample.
    Before, 48 kHz input was just decimated by 2, so sound above 12 kHz
    folded into the band whose zero-crossing rate and speech-band share
    decide a discard. Response checked numerically: flat to 10 kHz, -67 dB
    at 12 kHz (48 kHz input), -77 dB (44.1 kHz).
    - The header now states what the harness doesn't model: the 5 s pause
    after 3 discards in a row, the re-arm delay after a reply (playback
    plus cooldown), and the room-adapted noise floor (each file st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
2026-10-22 Reconnect: retry OpenAI at once when Wi-Fi comes back
    Going offline slows the OpenAI retries to every ~30 s, and nothing sped
    them up again when Wi-Fi returned (or a new network connected), so the
    session came back up to ~36 s after the Wi-Fi LED went green. Now the
    Wi-Fi rising edge resets the backoff (next try within ~1 s); if OpenAI
    is still unreachable 10 s later (Wi-Fi up, no internet), the offline
    pace is set again so failed connects don't hold loop() up every second.
    Finding FW-03.
2026-10-22 LISTEN: refuse it while the greeting, timer or ASK answer is on its way
    A manual LISTEN (Talk, the LISTEN command, the BOOT button) was accepted
    between the greeting's / timer announcement's / typed question's
    response.create and its first audio, so that reply's audio was dropped
    and its response.done could pass the LISTEN early. Now:
    - startManualListen() refuses while a response is pending or speech is
    playing, with a LOG_INFO line;
    - @@STATE reports "speaking <greeting|timer|typed>" (not "ready") while
    such a response is pending, and "processing" while a cancelled one
    drains - both existing state names, so the control center disables
    Talk then;
    - only a LISTEN's own response.done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
2026-10-22 Connection: heartbeat, and a silent server closes the socket
    With Wi-Fi up but the internet gone, the socket to OpenAI went half-open
    and stayed "ready": every LISTEN failed after 15 s with a green OpenAI
    light, never going offline.
    - The WebSockets library's ping/pong heartbeat is on: a ping every 15 s,
    and 2 pongs in a row missing for 10 s each close the connection
    (kHeartbeatIntervalMs / kHeartbeatPongTimeoutMs / kHeartbeatMissedPongs
    in parameters.h; an interval of 0 switches it off). The pong timeout
    is generous because a pong can queue behind a reply's audio while
    reads are paused for backpressure.
    - The reply timeout (15 s of server silence) now also closes the
    connection,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
2026-10-22 Offline: the OpenAI check turns red whenever the board goes offline
    A failed connect (DNS / TCP / TLS, e.g. Wi-Fi up but no internet) raises
    no disconnect event, so the only red "offline" report never came and the
    OpenAI light stayed orange ("connecting"). Going offline now reports the
    OpenAI stage as failed ("offline - retrying every 30 s") with the
    connection started, and so does the end of the fast retries after Wi-Fi
    comes back; Wi-Fi coming back shows it as "Wi-Fi is back -
    reconnecting" until the session is ready.
    Finding FW-05.
2026-10-22 Step verdict: a dropped connection no longer fails HANDS-FREE
    A LISTEN cut off by a Wi-Fi or OpenAI drop went through
    countTowardStepVerdict() while the Wi-Fi / OpenAI checks were down, so a
    routine hotspot-off demo printed a red "===== HANDS-FREE FAILED: ... ====="
    banner and the heap table. Such a LISTEN still prints its own
    "LISTEN #N FAILED" line, but now neither counts toward nor breaks the
    hands-free streak.
    Finding FW-06.
2026-10-22 Wi-Fi: fall back to the default network; keep a password's spaces
    - A network saved from the control center that fails
    kWifiAttemptsBeforeFallback (2) attempts in a row - the boot wait, then
    the once-a-minute restart - makes the board try SECRETS.h's network
    instead, and the default one failing as often switches back. Only in
    RAM: the saved network stays in flash, so a mistyped password or a
    hotspot that's gone no longer needs the laptop to recover (about a
    minute after boot).
    - WIFI_PASSWORD now takes the password from the untrimmed line (exactly
    one space after the word), so spaces at its ends are no longer
    stripped. A trailing '\r' is removed from every command line.
    Findi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
2026-10-22 Errors: don't hold hands-free for 15 s after a server error
    An "error" event (e.g. a rejected response.create) left
    response_in_flight set until the 15 s reply timeout, so hands-free
    didn't re-arm while the state showed Ready. The board now tracks whether
    the server actually has a response running (response.created ..
    response.done); an error with none running clears response_in_flight.
    A response.created always marks a response as in flight again, so one
    that survives an error is still waited for.
    Finding FW-09.
2026-10-22 Talk button: sample the debounce on a timer, not per loop() pass
    The BOOT button was sampled at most once per loop() pass, and a pass
    takes ~40 ms during playback (i2s_write), so the 6-sample debounce
    needed ~240 ms of held press and a quick tap to cancel could be missed.
    A periodic esp_timer now samples it every kButtonSampleMs (5 ms) with the
    same saturating counter (6 samples = 30 ms) and flags the press;
    takeButtonPress() just takes the flag. The timer runs only while the
    button is switched on.
    Finding FW-10.
2026-10-22 ASK: the 200 limit is bytes - say so, and log a cut
    The typed-question limit counts UTF-8 bytes, not characters (a Hebrew
    letter is 2 bytes, so about 100 letters fit). The constant is now
    kMaxTypedQuestionBytes, its comments say bytes, and a question that gets
    cut logs a LOG_INFO line with its size and what was sent instead of
    being cut silently. The limit itself (200 bytes) is unchanged.
    Finding FW-11.
2026-10-22 Clock: Israel time zone with automatic summer time
    TIMEZONE_POSIX is now defined as "IST-2IDT,M3.5.5/2,M10.5.0", so the
    clock (greeting, "what time is it?", timers' clock) follows Israel
    summer time by itself instead of a fixed UTC+2. The code path was
    already right: with TIMEZONE_POSIX defined, startTimeSync() calls
    configTzTime(), which (ESP32 core 2.0.17) sets TZ and calls tzset().
    TIMEZONE_UTC_OFFSET_SEC stays as the fallback when it is removed.
    Comments and Parameters/parameters.md updated. (M3.5.5 = last Friday of
    March matches Israel's "Friday before the last Sunday" through 2027;
    in 2028/2029 it would start a week late.)
2026-10-22 Parameters: move the user-tunable constants into parameters.h
    Hard-coded values a user might want to tune now live in
    esp32va_params (parameters.h), one comment each, and the modules use
    them under their old local names, so the logic is unchanged:
    - kStalledReplyRecordingTimeoutMs 20000 (reply_recorder_utils.cpp)
    - kHandsFreeMaxDiscardsInARow 3, kHandsFreeDiscardPauseMs 5000
    (hands_free_utils.h)
    - kDefaultVadSensitivity 3, kMin/Max/DefaultVadHangoverMs 600/1500/1000
    (vad_utils.h, which now includes parameters.h - pure C++, so
    tools/vad_replay.cpp still builds)
    - kWifiRestartConnectAfterMs 60000, kNtpServer1/2 (wifi_utils.cpp)
    - kMaxTypedQuestionBytes 200 (ESP32.ino)
    - kTimerAlarmBeeps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
2026-10-22 Comments: drop stale references in the firmware
    - No more Gemini-era mentions (the reconnect debug line, the root CA
    comment) or "every sketch since step 09".
    - The session message's comment describes what it is now, not a diff
    against step 21.
    - should_keep_running and loop()'s doc said the board stops when the SD
    card is unusable or the connection can't be set up; it only stops when
    the mic task can't start.
    - The disconnect comment no longer says the idle timeout is still to be
    measured "in step 16".
    Step references that point at Documentation/versions.md or decisions.md
    (which have those entries) are kept. Comments only, no code change.
    Finding DOC-16.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
2026-10-22 Docs: original edge-case PDF is edge-cases.pdf, matching its .md
    The content is regenerated from edge-cases.md separately.
2026-10-22 Control center: Wi-Fi passwords keep their edge spaces again
    The board now keeps spaces at either end of a WIFI_PASSWORD (everything after
    the word and one separator space), so the page no longer refuses them and
    sends the password untouched. A password of only spaces is "no password" to the
    board, so it is sent as an open network. The 8-64 byte limit stays.
2026-10-22 Control center: demo checklist follows the final stories and demo plan
    The checklist now lists the 22 user stories in the printed order, numbered,
    and the extended edge cases the plan shows, each with its case number. New
    items: Self-test, "How are you doing?", Hebrew, Cancel, no-PC, Replay, silence,
    far speech, several requests in one command, network switch. The typed question
    is story 13 and the stale 10-second item is gone. Self-test, Cancel, network
    save and get_board_status tick their items by themselves. Timer examples are
    30 s for the reminder and timer, 20 s for "turn off the light"; the demo clock
    follows the plan's 25-minute timeline; the Self-test clock hint no longer asks
    for a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
2026-10-22 Docs: README matches the final connection behavior and parameter locations
    Offline/reconnect, the heartbeat, the silent-server reconnect and the
    SECRETS.h network fallback are stated plainly; the Replay and CSV notes
    follow the control center; the voice-detector defaults point at parameters.h;
    the timer example is 30 s like the other demo documents.
2026-10-22 Docs: architecture - heartbeat, fast reconnect, refused Talk and the protocol notes
    Adds the two-missed-pongs rule, the 10 s fast-retry window and the orange
    "Wi-Fi is back" check, that Talk/LISTEN/BOOT are refused while an answer is on
    its way, that a connection drop is not a hands-free failure, the CSV
    board_session/board_command columns behind @@TIMING's n, the Replay note,
    the fallback to the default network in @@WIFI_NET, and the WIFI_PASSWORD
    rules (edge spaces kept).
2026-10-22 Docs: edge cases - fast reconnect, network fallback, silent server, refused Talk
    Both edge-case lists now say what the final firmware does: OpenAI reconnects
    within seconds when Wi-Fi returns and falls back to 30 s retries after 10 s,
    a failing saved network is replaced by the SECRETS.h one, a silent server
    closes and reopens the connection (the conversation is lost), Talk/LISTEN/BOOT
    are refused while the greeting, a timer announcement or an ASK answer is on its
    way, and an over-long typed question is cut with a log line.
2026-10-22 Docs: demo plan - checklist order, failed network switch, silent-server recovery
2026-10-22 Docs: board tests - item 13 says which part ran on the board
    The wrong-password test ran before the automatic fall back to the SECRETS.h
    network; the report keeps its result and says the fall back is untested.
2026-10-22 Docs: decisions - hands-free vs. a noisy room
    FX-04: new entry with the decision (optional, off by default; Talk, BOOT and
    typed Ask always remain), the assumption, what was and was not tested (the
    README VAD table and the board test), and the fallbacks.
2026-10-22 Docs: decisions - the simulated light sensor
    FX-05: new entry. The LDR is not wired and is simulated from the control
    center; lists what is real (tool, NVS thresholds, band mapping, the ADC path
    behind LIGHT_SENSOR_PIN, unit test 09) and how it is demonstrated (manual
    slider plus the Auto day-cycle).
2026-10-22 Docs: decisions - API cost entry, Technion Wi-Fi settled as an assumption
    FX-09 + rules slide 20: new entry on the cost of the paid Realtime API (model,
    what drives cost, official price table, how to compute a question; no
    per-question number because the reply length in tokens was never recorded).
    The Technion Wi-Fi entry now says plainly that the board did not connect, that
    the reason was not verified (WPA2-Enterprise or a captive portal is an
    estimate) and that the demo runs on a phone hotspot.
2026-10-22 Docs: modules are single-instance objects, with a hardware-to-module table
    GC-03 (doc only, no code change): decisions entry explaining why each esp32va_*
    module is one object (private state in the .cpp, interface in the .h) and not
    a C++ class, plus the hardware to module table, repeated in architecture.md.
2026-10-22 Docs: decisions - why the OpenAI key and Wi-Fi provisioning stay as they are
    GC-01: the API key is the manufacturer's data (it stays in SECRETS.h at build
    time); no Bluetooth / access-point provisioning because of the heap on a board
    with no PSRAM, Wi-Fi settings go over USB Web Serial instead.
2026-10-22 Docs: decisions - deliberate limitations (no OTA, wireless debugging, MQTT)
    GC-08: each needs another socket and more RAM on a board with no PSRAM; the
    entry lists what exists instead (offline operation, log Replay, SD recordings).
2026-10-22 Docs: decisions - nothing is queued offline, on purpose
    ST-06: why a question asked offline is refused at once instead of buffered, and
    what is kept instead (SD recordings, settings in flash, the page's log and
    statistics CSV); the timer and controls keep working offline.
2026-10-22 Docs: architecture - @@ALIVE, @@LIMITS, BOOT tones and technician check
    ST-04, GC-14, ST-01/FX-08 (docs): the two new status lines in the protocol
    table, the loop() step that prints @@ALIVE, a short section on the BOOT
    button tones and the 2 s technician beep check, and the SD card pulled at
    runtime in the module table.
2026-10-22 Docs: architecture - state diagram gets the cancel, failure and hands-free edges
    FX-13: listening to ready (Cancel / not speech), processing to ready (failure),
    speaking to armed (Hands-free on) and speaking to ready, matching the usage
    flow chart and the priority table.
2026-10-22 Docs: architecture - all the mocks under one heading
    GC-02: new section listing the simulated light sensor (manual slider and Auto
    day-cycle; the real path is LIGHT_SENSOR_PIN), log Replay, tools/vad_replay and
    typed Ask.
2026-10-22 Docs: unplug USB first, then connect the power bank (never both)
    FX-01. The docs told to connect the power bank before unplugging USB, which
    feeds a second power source while the PC is attached (course rules, slide 21).
    New order everywhere: unplug USB, then power bank; the board restarts (~10 s
    to the greeting) and keeps its saved settings. Case 9 (control center
    disconnected) now demonstrates by unplugging the cable and says the board
    restarts. Safety line added to the demo-plan day-before list and the README
    install/run section; the README power-bank row notes "not together with USB".
2026-10-22 Docs: drop the confusing power-bank parenthesis from the original edge-case list
    FX-13 (the part in edge-cases.md, row 7).
2026-10-22 Docs: add the missing rubric rows to the printed edge-case list
    ST-02 (also covers the doc side of ST-01, ST-04, ST-07, ST-08). New rows
    25-33 in a new "stability and recovery" section, appended so existing numbers
    stay valid: the clock before time sync, a flood of commands, the user walking
    away, the board restarting or not responding with the page open (@@ALIVE),
    mic clipping, an SD card pulled at runtime, invalid timer values, a refused
    BOOT press (refused tone / start tick) and the technician beep check.
    Row 12 gets its check cell, row 15 now says BOOT during a LISTEN's reply
    cancels it (only the greeting, timer and typed answer refuse it), and rows
    20 and 21 get their indication text.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
2026-10-22 Docs: argue why questions are not buffered while offline
    ST-06. New row 34 in the printed edge-case list: nothing needs buffering
    offline (no database or cloud log, recordings go to the SD card regardless);
    questions are not queued on purpose (an answer minutes later would confuse,
    the refusal is immediate and visible); the timer and controls keep working.
2026-10-22 Docs: map every state to what the board itself shows or plays
    FX-07 (with the doc side of ST-01, ST-04, ST-07, ST-08). New "no PC" section
    in system-states-and-errors.md: per state or event, what the board shows or
    plays without the control center (start tick, refused tone, technician beep
    check, timer beeps; offline/online/failed tones only with Status sounds on),
    and that the onboard LED is the user's light, not a status light. The states,
    Board health and error tables now cover the refused tone, the "Board not
    responding" warning, a pulled SD card, the USB banner and the timer limits.
2026-10-22 Docs: README lists the ESP-IDF APIs the code really calls directly
    FX-11. NVS is used through the Arduino Preferences class, not directly. The
    README now lists what is called directly (driver/i2s.h, xTaskCreatePinnedToCore,
    esp_timer, heap_caps_*, esp_random, mbedTLS base64) and what goes through
    Arduino wrappers (Preferences, ledc, configTime, SD, Wi-Fi).
2026-10-22 Docs: BOOT button sounds and the technician check in the user-facing docs
    ST-01, FX-08. Quick start, user story 20, edge-case row 11 and the demo plan's
    no-PC slot now mention the start tick, the refused tone and the 2 s
    technician beep check (Wi-Fi, OpenAI, SD card, mic; high = OK).
2026-10-22 Docs: a pulled SD card turns the SD light red - quick start and demo plan
    ST-07. The quick-start and demo-plan troubleshooting rows now cover a card
    removed while the board runs (light stays red until Reset).
2026-10-22 Docs: quick-start rows for the download lock, "Board not responding" and the USB banner
    ST-03, ST-04, FX-01. Talk reads "Downloading…" while a recording downloads (a
    documented limitation: the board holds its loop for the transfer); the
    heartbeat warning; the USB banner now says the board restarts.
2026-10-22 Docs: quick start explains saving a Wi-Fi network during the boot wait
    ST-05. The Wi-Fi card shows "Sent - the board reads it once its Wi-Fi wait ends
    (up to 20 s)…" and waits up to 40 s for "Saved".
2026-10-22 Control center: Demo checklist - unplug USB first, then the power bank
    FX-01: the "20. without a PC" and "9. disconnecting the control center"
    checklist items told the user to connect the power bank before unplugging
    USB, i.e. two power sources at once (course safety rule). Now: unplug USB
    from the PC, only then connect the power bank (never both); the board
    restarts with its saved settings (~10 s to the greeting). Item 9 is just
    unplugging the cable: the board, powered from it, restarts on replug. The
    lost-USB banner no longer claims the board keeps running.
2026-10-22 Control center: lock Talk and Ask while a recording downloads
    ST-03: a GET holds the board's loop() for the whole transfer (up to ~40 s
    for a 10 s voice command), so a Talk click meanwhile sat in the UART and
    started a recording long after. Talk, the Ask box and the phrase buttons
    now wait while a download runs (Talk reads "Downloading…"); a counter of
    running GETs, decremented on success, failure and abort alike, drives it.
2026-10-22 Control center: Wi-Fi save during boot waits for the boot Wi-Fi wait
    ST-05: setup() reads no commands during its Wi-Fi wait (up to 20 s) and
    clock sync (up to 15 s), so a network saved then was answered only after
    the 4 s ack timeout and the page said "didn't confirm" although the board
    saved it. While the board is still booting (no @@STATE yet, or "booting")
    the note now says the board reads it once its Wi-Fi wait ends, and the
    page waits 40 s before "didn't confirm". The normal case is unchanged.
2026-10-22 Control center: clear the timer chip when the board restarts
    ST-10: the voice timer lives in the board's RAM, but after a Reset with
    the page still connected the chip kept counting down a timer that no
    longer existed and then sat at 0 with no ring. The "STATE booting while
    running" restart detection now clears it.
2026-10-22 Control center: flag a board that stopped reporting (@@ALIVE heartbeat)
    ST-04: a connected board that stopped printing (a hung loop()) kept its
    last state on screen forever. The page now reads the board's @@ALIVE
    heartbeat (every 5 s): once the first one has arrived since connecting or
    restarting, 15 s with no line at all from the board greys out the
    assistant's state and the health lights and shows "Board not responding -
    no report for 15 s. If it stays like this, press Reset (EN) on the board."
    The next line from the board clears it. Not watched during a recording
    download (it holds loop() on purpose), during log Replay, after a restart
    until the next @@ALIVE, or at all with older firmware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
2026-10-22 Control center: take the board's limits from @@LIMITS
    GC-14: the page kept hand-copied firmware limits (typed-question and
    Wi-Fi lengths, kept recordings, mic gain, light range, hands-free ranges
    and utterance length). It now reads the board's
    "@@LIMITS key=value ..." line (sent with the STATUS answer and at boot)
    into one `limits` object and uses it everywhere those numbers were used,
    including the inputs' maxlength and the sliders' and number fields'
    min/max. Without @@LIMITS (older firmware) the built-in defaults - the
    same numbers as before - stay; they come back on every connect,
    disconnect and replay. Unknown keys and non-integer values are ignored.
    Also fixes the stale "mirrors ..." c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
2026-10-22 Control center: auto day-cycle mode for the simulated light sensor
    GC-02: the simulated LDR was only a hand-set constant. A "Simulate:
    Manual (slider) / Auto day-cycle" menu next to the light slider now adds
    a mock that behaves like a real sensor: one simulated 24 h day every
    2 minutes (DAY_CYCLE_PERIOD_MS), a LIGHT <v> every 1.5 s following a
    smooth night -> sunrise -> day -> sunset curve (dark ~280, noon ~5550 on
    the 0-6142 scale, so it crosses the evening and day thresholds), plus
    ADC-like jitter of a few counts x1.5, clamped to the board's range. The
    slider follows the sent value and the simulated time of day shows next
    to the menu. Touching the slider goes back to Manual. Sending pauses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
2026-10-22 Control center: move the JavaScript into control_center.js
    GC-11: control_center.html was ~4,400 lines in one file. Its script now
    lives in control_center/control_center.js, loaded at the same place with a
    classic <script src="control_center.js"> (not a module: modules are
    blocked on file://, so double-clicking the HTML keeps working). The move
    is byte-identical (checked against the previous commit's inline script,
    line endings normalized). The CSS stays inline: Save report copies the
    page's <style> text into the saved report. Nothing else depended on the
    script being inline (no document.currentScript, no inline on*= handlers;
    Save log, Tour and Replay are unaffected - Tour, Summary, Stage v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
2026-10-22 Timer: set_timer rejects negative/sub-second values and says when the 1-hour cap applied
    ST-08: 0 still cancels; a negative or 0-1 s value answers the model with an error (so it asks again) and leaves a running timer alone; over the cap is set to the cap and the tool output says it was capped.
2026-10-22 SD card: re-check the card after a recording file error and turn the SD check red if it's gone
    ST-07: the recorders note a failed open/write/close (a flag only, safe in the WebSocket callback); loop() re-checks the card once the board is idle by opening its root folder (SD.cardType() is cached at mount). A card that no longer answers is marked unusable for good - recordings stop, LIST/GET/DELETE answer "no SD card" as after a no-card boot - and @@STAGE sd fail asks to insert it and press Reset.
2026-10-22 Heartbeat: the board prints @@ALIVE <uptime s> every 5 s from loop()
    ST-04: printed through printProtocolLine(), which first ends a streamed transcript line still open, so @@ALIVE always starts its own line. Not printed during setup()'s waits or a GET's transfer (both hold loop()); printed while halted too, since loop() still answers LIST/GET. New kAliveIntervalMs in parameters.h, with its parameters.md row.
2026-10-22 Limits: the board prints its fixed limits as @@LIMITS at boot and for STATUS
    GC-14 (firmware side): esp32va_info::announceLimits() prints max_ask_bytes, Wi-Fi name/password sizes, max_kept_recordings, mic_gain, light_max, max_utterance_ms and the hands-free sensitivity/hangover ranges from the firmware's own constants. The Wi-Fi limits move from wifi_utils.cpp into wifi_utils.h (the minimum password length was a literal 8) so the line can use them; parameters.md lists them.
2026-10-22 Talk button: a start tick before every manual recording and a refused tone for a BOOT press that can't start one
    ST-01 / FX-08: startManualListen() now returns whether it started. Every manual LISTEN (BOOT, Talk, LISTEN; not hands-free) plays a short high tick, waits until it has left the speaker (new esp32va_audio::waitUntilPlayedOut()) and only then starts the capture, which has no pre-roll - so the tick isn't recorded. Hands-free is held off around it as for BEEP. A refused BOOT press plays a short low tone; it is skipped while the mic is recording a hands-free utterance, and spliced into the speech if the greeting or a typed answer is playing. Both are always on (not the SOUNDS setting),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
2026-10-22 Talk button: holding BOOT for 2 s plays the technician beep check
    ST-01: with the BOOT button switched on, button_utils' esp_timer sampler counts how long a debounced press is held and flags a long press once per hold (takeButtonLongPress()); the short press still acts on the press edge as before. runTechnicianCheck() cancels the LISTEN this same press started (if still recording or awaiting), then plays one beep per check - Wi-Fi (connected now), OpenAI (session ready now), SD card (usable now), mic (its startup check) - high = ok, low = failed, with hands-free held off around it, and logs the result in one INFO line. New constants in parameters.h with parameters.md rows.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
2026-10-22 Refactor: session.update message moves to realtime_session_config.h
    GC-07. The ~5 KB single line in ESP32.ino (instructions, audio formats,
    six tool schemas) moves to a data-only header (namespace esp32va_session,
    included by ESP32.ino alone), split into adjacent string literals: one
    instruction sentence or one JSON field per line. Compile-time
    concatenation, so the sent bytes are identical (checked by rebuilding the
    string from both versions). parameters.h notes it is the project's
    config_parameters.h.
2026-10-22 Refactor: one shared commandArgument() and parseOnOff()
    GC-04 (part a). New command_parse_utils.h/.cpp (namespace esp32va_cmd)
    replaces the copies in device_controls_utils, hands_free_utils,
    sd_file_transfer_utils and wifi_utils (using-declarations keep the call
    sites as they were). Three commandArgument copies and both parseOnOff
    copies were byte-identical; wifi_utils' copy was written differently but
    returns the same for every input ('\0' -> "", ' ' -> skip spaces, else
    nullptr).
2026-10-22 Refactor: one tool-reply helper, sendFunctionCallOutput()
    GC-04 (part b). esp32va_openai::sendFunctionCallOutput() in
    openai_realtime_utils replaces the five hand-rolled function_call_output
    snprintf + sendTXT copies (board_info, board_state, clock_timer,
    device_controls, light_sensor) and their five private buffers (256-384
    bytes) with one static 384-byte buffer. Same template, same bytes on the
    wire (checked for every tool's outputs), same overload of sendTXT, still
    called from the same place; each module keeps its own LOG_DEBUG line.
2026-10-22 Refactor: kSampleRateHz is defined once, in vad_utils.h
    GC-04 (part c). ESP32.ino and i2s_audio_utils.cpp alias
    esp32va_vad::kSampleRateHz instead of each writing 24000 (vad_utils.h is
    the pure C++ header tools/vad_replay.cpp also builds, so it keeps the one
    definition). Same value, same type.
2026-10-22 Refactor: named state-machine transitions in ESP32.ino
    GC-12 (plus GC-04's "response requested" / "clear response flags"
    helpers). Every run of two or more flag writes that makes one transition
    moves, statement for statement and in the same order, into a named helper
    in one "State machine: the transitions" section (enterListening,
    enterAwaitingReply, noteCaptureAborted, noteListenDropped,
    noteListenCancelled, noteVerdictReached, noteResponseRequested,
    noteUnpromptedResponseRequested, noteResponseCreated,
    noteCancelledResponseOver, noteFailedResponseDone,
    noteCancelledResponseAlreadyOver, noteResponseRejected,
    clearResponseFlags, noteSessionLost). Flag writes only - calls, sends and
    logs stay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
2026-10-22 Refactor: split ESP32.ino into Arduino tabs
    GC-10. ESP32.ino (now ~430 lines) keeps the header, includes, the shared
    flags and constants, a declaration of every function the tabs define
    (the IDE's prototype generator skips namespaced functions), setup() and
    loop(). The functions move, byte-identical and in their original relative
    order, into listen_turn.ino, serial_commands.ino, server_events.ino,
    state_machine.ino (GC-12's transitions + updatePipelineState() and the
    checks) and verdicts.ino, each reopening the anonymous namespace. Checked
    by concatenating the tabs in the builder's order against the old file:
    all 58 function blocks identical, all 56 declarations match their
    definitions; only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
2026-10-22 Comments: the control center takes the mic gain from @@LIMITS
    GC-14 follow-up: the firmware comments and calibration.md no longer ask to
    edit BOARD_MIC_GAIN in the page by hand.
2026-10-22 Docs: README firmware row lists the sketch's tabs
    GC-10 follow-up: ESP32.ino is now split into Arduino tabs; the folder table
    names them and where the state machine lives.
2026-10-23 Docs: user stories lead with the main features, in sections
    The stories are re-sorted (talking and voice control of the board first,
    Self-test moves to 14), grouped into 7 sections, and split into "what you
    do" / "what should happen" with an edge-case column. Story 1 lists the
    health lights that exist. The demo plan, the Demo checklist and the demo
    clock follow the new numbering.
2026-10-23 Docs: edge case 25 shows the clock on the OpenAI light
    The page has no Time light; while the clock syncs, the OpenAI light shows
    "Syncing the clock…", and a time-server failure turns it red.
2026-10-23 Docs: regenerate the user-stories, edge-cases-extended and demo-plan PDFs
    The user stories now print in landscape (3 pages).
2026-10-24 Hands-free by voice, no listening during laptop playback, run-time API key
    - set_hands_free, a 7th tool, switches hands-free exactly like the control
    center's switch (setHandsFree(), shared with VAD on|off). Strict
    instructions: only for an explicit request in this very message, never
    for a question about the mode or unclear audio. The tool takes the wanted
    state, not "toggle", and the board takes it only while answering the user
    (a LISTEN or ASK) - never during the greeting or a timer announcement.
    - LAPTOP_PLAYBACK on <ms>|off: while the control center's player plays a
    recording out loud, hands-free doesn't listen, and a hands-free utterance
    already being recorded is cancelle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
2026-10-24 Docs: hands-free by voice, laptop playback, the API key card
    README, architecture (commands, @@OPENAI_KEY, @@LIMITS), parameters,
    states and errors, edge cases 35-37, user stories 2, 9 and 15, the demo
    plan and versions. decisions.md reverses "the API key isn't set from the
    control center" and adds the voice switch and the laptop playback hold.
    The PDFs aren't regenerated yet.
2026-10-24 Docs: translate the README and the documentation to English
    All Markdown docs in Documentation/ and the README, with the
    right-to-left wrappers and direction marks removed. The five printable
    PDFs are regenerated from the English text. The measurement log keeps
    the speech it recorded as is.
2026-10-25 Make Wi-Fi and OpenAI recovery robust after a hotspot drop
    - Track Wi-Fi from the ESP32's events instead of WiFi.status(): core
    2.0.17 leaves it at WL_CONNECTED after an AUTH_EXPIRE disconnect, and
    its WiFi.begin() then never reconnects. The sketch now reconnects by
    itself every few seconds, with the core's auto-reconnect off (its
    retries stopped while the hotspot was off).
    - Don't poll the WebSocket library or count OpenAI attempts while Wi-Fi
    is down; the OpenAI check shows "waiting for Wi-Fi".
    - Clear speech_in_progress when the session drops, so a due timer rings
    and the offline sound plays during an outage.
    - After booting offline, play the online sound before the greeting.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
